saravmajestic/yaerbot/docs/drive-precision.md

# Farm OS — Drive Precision: straight lines and accurate turns

Why the robot doesn't drive straight or turn to an exact angle, what we measured, and
what actually fixes it. Written after a long debugging session on 2026-08-09..11 that
found **three independent faults** stacked on top of each other, plus one property of
skid-steer robots that no amount of tuning removes.

Read this before "fixing the trim" — trim was the wrong answer three times out of four.

> **Status.** The turn problem this document opens with is **solved**: a gyro is fitted and
> turns close the loop on measured angle (0.3° worst over four consecutive 90° turns). What
> is still open-loop is **distance** (timed, no encoders) and **straight-line heading**
> during a hop (`ltrim`). The three faults below are the ones worth knowing about, because
> they cost a week and none of them was the trim.

---

## TL;DR

| Want | Answer |
|---|---|
| Straight hops | trim + all four wheels gripping. Still open-loop: the gyro corrects *turns*, and per-hop heading is measured and logged but not yet steered on. |
| Accurate turns | **Solved.** A gyro is fitted and turns close the loop on measured angle: worst error **0.3°** across four consecutive 90° turns. Open-loop, this was never better than ~±5°. |
| Accurate hop distance | timing works if dead time is calibrated; wheel encoders make it exact. |

**One rule:** before adjusting any control parameter, prove the command reached the motors.
`getDiag` (see below) does that in one line.

---

## The faults we found, in the order they mattered

### 1. Loose IBT-2 signal wiring (worst, and invisible)

Dupont jumpers on the IBT-2 signal header **degrade progressively under vibration**. The
signature is nasty because it isn't a clean failure:

- Early in a session: `fwd 180 4s` → 2.60 m, dead straight
- An hour and a dozen runs later: **the same command drove a half circle**

Because it drifts, every calibration taken during that window is worthless, and any
parameter fitted to it will not converge — we watched a "required trim" climb 1.24 → 1.33
while chasing it. **Solder the signal lines and strain-relieve them to the chassis.**

### 2. One wheel not touching the ground

A **rigid 4-wheel chassis is over-constrained** — like a wobbly table it rests on 3 of its
4 contact points unless the axles are coplanar. On this robot two motor shafts sat ~1 mm
proud of the others; one gripped fine and the other floated, because *which* corner floats
depends on how the frame is twisted, not on height alone. 1 mm matters because a rubber
tire only deflects about that much under a light robot.

Effects, all of which look like other problems:
- the side with the floating wheel loses ~half its traction → large veer
- that side cannot counter-rotate → **turns become forward arcs instead of pivots**
- forward dead time measured **0.524 s** (it was really 0.104 s — the drag inflated it)

Fix: loosen that motor bracket, let the wheel settle on a flat surface, retighten; shim
1 mm if the frame is twisted. Verify all four wheels take load (rock the robot diagonally;
try sliding paper under each wheel).

> **On soil this matters much less** — soft ground conforms to a millimetre and all four
> wheels find grip. Some of what we chased is a hard-floor artifact. Re-test on real
> ground before doing mechanical surgery.

### 3. Normal motor variance — not a fault

Two nominally identical DC gearmotors run **5–15% apart at the same PWM**. It is
manufacturing tolerance (internal resistance, brush friction, gearbox drag) and every
hobby 4WD robot has it. Measured here by counting free-spinning wheel revolutions:
**5 left vs 4.75 right → 5%.** That is normal, and it is what trim is for.

### 4. Rotational coast — a property, not a fault

A skid-steer turn is low-friction, so the chassis keeps spinning after the brake:

| Turn duty | Coast |
|---|---|
| PWM 180 | **~75°** |
| PWM 120 | **~38°** |

At PWM 180 a 90° turn is *mostly* coast, so timing it is hopeless. **Turn at a lower duty.**

---

## The measurement that unlocked it

Two numbers that should have agreed, didn't:

| Condition | Right-side deficit |
|---|---|
| Free-running (revolution count; motor terminals 6.72 V vs 6.64 V = 1.2%) | **5%** |
| Driving under load (inferred from veer geometry) | **25%** |

**Free-running measurements hide load-dependent faults** — no current flows, so nothing
sags and nothing slips. Always take the loaded measurement too (push the robot against a
wall and probe the motor terminals). The 20-point gap was traction, not electrics.

---

## Calibration procedure (works, ~10 minutes)

Use `scripts/field_test.py` on the board. Recalibrate after **any** mechanical or wiring
change — every value below is surface-, battery- and hardware-specific.

```bash
# field_test.py lives in scripts/ — copy it to the app dir first, it is not deployed
scp scripts/field_test.py unoq:/home/arduino/motor-control/python/
FT="ssh unoq docker exec motor-control-main-1 python3 /app/python/field_test.py"

# 0. sanity: does the MCU receive what we send?
$FT diag

# 1. forward: two durations -> cruise speed AND dead time
#    CALIBRATE AT THE DUTY THE ROBOT ACTUALLY RUNS AT — that is PWM 55 now, not 180.
$FT fwd 55 30 0.83      # measure distance
$FT fwd 55 10 0.83      # measure distance
$FT solve 30 <d_long> 10 <d_short>

# 2. turn: two durations at the LOW turn duty -> rate and coast
$FT turn 120 1.5 right  # measure angle
$FT turn 120 0.8 right  # measure angle
$FT tsolve 1.5 <a_long> 0.8 <a_short>

# 3. validate one seeding row
$FT row total=1.2 hop=0.4 turn=90 dir=right \
      speed=<s> startup=<st> ltrim=<lt> tpwm=120 tdps=<r> tstartup=<c> nobatt

# 4. validate the ROW CHANGE (two same-direction 90s + the gap)
$FT uturn leg=1.0 gap=0.4 turn=90 dir=right <same params>
```

**Two models, opposite signs — don't mix them up:**

```
forward:  time = startup_s      + distance/speed      startup_s  > 0   (dead time)
turn:     time = turn_startup_s + angle/tdps          turn_startup_s < 0   (coast)
```

A dead time means *nothing happens at first*; a coast means *it keeps going after you
stop*. If `tsolve` hands you a negative dead time, that's a coast — expected for turns.

### Reference numbers — current (measured 2026-08-18 on soil)

Live values are in `CAL` in `console/python/main.py`. **Plot mode now drives at creep duty
(PWM 55), the same speed as drip seeding**, so one calibration covers both kinds of run
instead of two that can drift apart.

| Parameter | Value | Note |
|---|---|---|
| `pwm` | 55 | forward duty for both plot and drip |
| `speed` | 0.165 m/s | `fwd 55 30` → 5.00 m, `fwd 55 10` → 1.70 m |
| `startup` | **−0.303 s** | negative at this duty — see below |
| `ltrim` | 0.83 | |
| `turn_pwm` | 120 | |
| `tdps` | 45.2 °/s | |
| `tstartup` | −0.80 s | ≈36° of coast |
| `tramp` | 0.0 | ramp available, off |

→ a 40 cm hop is **2.12 s**, not the 0.75 s of the PWM-180 era. A 5 m row takes about 30 s.
Slower is also more accurate, less overshoot per stop — but PWM 55 is near the deadband, so
watch for stiction on rough ground.

**Why `startup` is negative here.** At PWM 180 it was a real dead time (+0.104 s: nothing
happens at first). At PWM 55 the two-point fit comes out negative, which is not a dead time
— it is the straight line through two slow runs having a negative intercept. Treat it as a
fitted constant for this duty, not as physics. The older PWM-180 pair (speed 0.640,
startup +0.187) is kept in the code comments so it is not lost.

---

## Measure the thing you can actually measure

Most of our bad data came from eyeballing angles. Reframe the measurement:

| Don't measure | Measure instead | Why |
|---|---|---|
| "is that 90°?" | **a full/three-quarter circle** | back-to-parallel is easy to judge; 90° is not |
| turn angle in degrees | **lateral offset in cm** over a known distance | tape measure, not judgement — then compute the angle |
| "did it veer?" | offset **per metre** | comparable across runs of different length |
| each 90° of a row change | **are the two legs parallel** | that's the output that matters operationally |

Angle from offset, for a constant-radius arc over path length `s`:

```
(s/θ)(1 − cos θ) = offset          → solve θ
R = s/θ ;  speed difference = track_width / R   (as a fraction of average speed)
```

Worth building: tape a laser pointer to the chassis and mark a wall, or lay a printed
protractor under the pivot point.

---

## Software solutions

### Implemented

- **Dead-time model on forward** (`startup_s + d/speed`). Without it a 40 cm hop is issued
  as a sub-dead-time burst that barely translates — this is why an early boustrophedon
  attempt "rotated randomly within a 30 cm square" instead of driving rows.
- **Coast model on turns** (negative `turn_startup_s`), with the sleep clamped at zero:
  a turn smaller than the coast angle is simply not achievable at that duty.
- **Separate turn duty** (`turn_pwm`) — forward wants 180, turns want 120. One shared duty
  cannot express both.
- **Deceleration ramp** (`turn_ramp_s`, default off) — steps duty down to a floor over the
  last fraction of a turn, then brakes. Coast scales with spin speed at brake time, so
  easing off first shrinks the coast *and* its run-to-run scatter. There is still only one
  stop, and it happens slowly. Calibration is unaffected as long as the ramp is fixed.
- **Battery compensation** — scales duty by `V_cal/V_now` to hold the calibrated speed
  (symmetric; clamped 0.75–1.5×). **Currently inoperative:** the divider was on A4, which
  the gyro took, so `BATT_PRESENT 0` and every run passes `nobatt`. The gain is 1.0.
- **Closed-loop turns** — `pivotDeg` on the MCU drives until the measured rotation reaches
  target, so coast and surface stop mattering: the result is measured, not predicted.
  Worst error 0.3° across four consecutive 90° turns.
- **`getDiag` self-checking** — after every move, compares what we sent against what the
  MCU latched and drove, and prints a `!!` banner on mismatch. Catches a broken command
  path *before* you start blaming control parameters.

### Available, not yet done

- **Fewer turns.** Every turn is an error source. Run rows along the **long** axis of the
  plot. A serpentine alternates turn direction between ends, so systematic overshoot
  partly cancels across a full cycle — but *not* within one row change (see below).
- **Auto-calibrate per surface, at the start of a run.** Half done: the MCU already learns
  pivot coast run-to-run with an exponential average, so it adapts to the ground it is on.
  What is missing is a deliberate known-angle turn at the start of a run to seed it — and
  **the learned coast is lost on reboot**, so the first turn after a power cycle uses the
  built-in guess.
- **Steer on heading during a straight hop.** The gyro closes the loop on turns; a hop is
  still open-loop with `ltrim`. Per-hop yaw is measured and logged, but nothing acts on it.

### The row change was the precision bottleneck ✅ **largely solved**

`A → B` (row), `B → B1` (**90°, row gap, 90°**), `B1 → C` (next row). **Both turns go the
same way**, so a *systematic* per-turn overshoot **doubles**: 10° per turn left the next row
20° skew. That was the open-loop failure. Closing the loop on the gyro takes the per-turn
error to about 0.3°, so the doubling is now under a degree. The geometry lesson still holds
for anything that stays open-loop:

- Tune the row change **as one primitive** (`field_test.py uturn`), not as two 90° turns.
  Its two outputs are separately measurable — heading (are the legs parallel?) and lateral
  (is the spacing the row gap?) — so two measurements pin two parameters.
- The row gap here equals the **seeder arm's outlet spacing**, so lateral error shows up
  directly as wrong seed spacing between rows.

---

## Hardware solutions, ranked by value per rupee

> **What was actually fitted:** a hand-wired **MPU-6050 on A4/A5** via `Wire2`. No wheel
> encoders.
>
> The plan below preferred a **Modulino Movement** on the Qwiic connector — no soldering, no
> GPIO cost. It went the other way for one reason: **the header pins marked SDA/SCL do not
> work for I²C on this core**, and `Wire2` on A4/A5 is the only solderable I²C the board has.
> Qwiic (`Wire1`/i2c4) does work but needs a JST-SH cable. A4/A5 were already spoken for, so
> the gyro cost the battery monitor its input — see [`bom.md`](bom.md).

### 1. IMU — highest value ✅ **done**

**MPU-6050 on A4/A5** (`Wire2`). Not the header `SDA`/`SCL` pins — those have no I²C
peripheral behind them on this core, so a bus scan there finds nothing however correct the
wiring looks.

Uses the **gyro only**: integrate yaw rate and turn until the measured angle reaches target.
Gyro drift is irrelevant over a 1–2 s turn. Coast stops mattering because you measure the
result instead of predicting it. This is what took turns from ±5–10° to 0.3°.

```
target = 90°
while |target − measured| > 2°:
    duty = clamp(Kp × error, 80, 140)     # automatically slows near target
stop, settle, re-read; one micro-correction if still out
```

Surface-independent, battery-independent, self-correcting. It **could** also remove the need
for trim by holding heading during a straight hop — that part is not built; hops still use
`ltrim`. For production use
a **BNO085/BNO055** (~₹1500–2500): on-chip fusion, absolute heading, no hand-rolled drift
maths. Mount on foam, away from the motors.

### 2. Wheel encoders — for distance, not for heading ⬜ **not fitted**

Be clear what they buy: in a skid-steer the wheels **slip by design during a turn**, so
heading derived from wheel difference is unreliable exactly when you need it. Encoders fix
**hop distance** (replacing the timing model); the IMU fixes **heading**. Different jobs.

Cheap option: **LM393 slot sensor + 20-slot disc** (~₹80–150). Tie both channels per side,
one digital pin, poll it (~30–50 pulses/s at our speed — no interrupt needed). A ~65 mm
wheel with 20 slots gives ~1 cm per pulse. Best implemented as a `driveDistance(pulses)`
RPC so the MCU closes the loop itself.

### 3. Mechanical — partly done

- **Wheelbase vs track.** A skid-steer with a *long* wheelbase relative to its track (32 cm
  here) scrubs hard and resists turning. Aim for wheelbase ≤ track.
- **All four wheels loaded** — shim coplanar, or add a rocker/suspension for uneven ground.
- **Weight distribution.** 4-wheel skid-steers turn *worse* at 50/50 front/rear — they buck
  and scrub. Deliberately loading one axle improves turning.
- **Tires** matched, clean, not glazed; narrower scrubs less.
- **Solder power and signal**, strain-relieved. Dupont goes high-resistance under load —
  the same lesson as the battery divider and the motor drive.

### Production stack

```
distance  ← wheel encoders        (closed-loop hops)      ⬜ not fitted — still timed
heading   ← IMU gyro              (closed-loop turns)     ✅ fitted, turns only
          ← ... + straight-line hold                      ⬜ not built — hops use ltrim
position  ← RTK GPS               (absolute reference)    ⬜ deliberately not used
```

---

## Debugging lessons (the expensive ones)

1. **Verify the command path first.** `getDiag` proves what the MCU received and which pins
   it drove. Without it we spent a dozen runs tuning parameters against a loose wire.
2. **Free-running measurements hide load-dependent faults.** Take the loaded one too.
3. **Don't re-fit the model to each new reading.** Hold several hypotheses and pick the test
   that *discriminates* between them. A theory that changes with every data point isn't a
   theory.
4. **A parameter that won't converge is telling you something.** "Required trim" climbing
   1.24 → 1.33 → never straight meant the fault wasn't trim-shaped at all.
5. **Small voltage differences don't cause big speed differences.** 1.2% of volts buys ~1.2%
   of speed. To explain 20% you need ~1.3 V, not 0.08 V.
6. **Beware the compensating parameter.** `ltrim=0.75` masks an asymmetry rather than fixing
   it, so it drifts as the pack sags. Note which parameters are papering over hardware.
7. **Check the newest change first.** Newly-mounted wheels, freshly-soldered joints, a
   just-flashed sketch. And **back up firmware before overwriting it** — we lost the ability
   to A/B a flash because the only copy of the previous sketch was clobbered.

---

## See also

- [`bom.md`](bom.md) — what is actually fitted
- [`troubleshooting.md`](troubleshooting.md) — connector, network and flashing failures
- `apps/farm-robot/docs/farm-os/wheel-encoder-build.md` in the **ai-labs** repo — how to
  build and mount a distance encoder, if one is ever fitted
- `apps/farm-robot/docs/farm-os/uno-q-wiring.md` in the **ai-labs** repo — pinout as it
  stood then. Superseded: the IMU went on **A4/A5** (`Wire2`), not the header SDA/SCL pins,
  which have no I2C peripheral behind them. Current sheets: `docs/schematic/`
- `firmware/farm_os/farm_os.ino` — `getDiag`, optional IBT-2 current sense (`CURRENT_SENSE`)
- `scripts/field_test.py` (yaerbot) — `diag`/`fwd`/`turn`/`solve`/`tsolve`/`row`/`uturn`/`plan`
