saravmajestic/yaerbot/docs/ml-emitter-model.md

# ML Emitter Model — capture → train → deploy

The **single** reference for the Edge Impulse FOMO emitter detector: how frames are
collected, labelled, trained, and how the model actually reaches the robot. Everything
below is verified on hardware unless marked otherwise — most of it was learned the hard
way on 2026-08-15/16.

> **Why this model exists:** classical CV could not tell an emitter from the tube it sits on.
> A learned model can, and it runs on the board. `vision/detect_emitter` stays as the automatic
> fallback, so nothing is blocked if the model underperforms.

> **Current state, 2026-08-19.** Deployed model is **v8** (§4), bound in `app.yaml`, gate
> `_EMIT_CONF = 0.60`. v8 closed the mid-frame blind spot: 7 of 19 frames now detect in the
> middle of frame against 0 before, which is what gives the robot room to stop.
> **The open problem is false positives on plain tube**, which is why a 12-emitter row draws
> about 14 stops. Fixing it needs negatives in the training set, not another threshold change.
>
> Also note the camera changed: frames are now **320×240 from a USB webcam seeing 43cm of
> ground**, not the ESP32-CAM's 22cm. Fire-rate figures measured before the swap are not
> comparable with ones measured after it.

---

## 0. The pipeline at a glance

```
USB camera ──V4L2──> UNO Q Linux ──> _cam_loop ──> detect_emitter_ml()
                                                        │  (falls back to
                                                        │   classical CV)
                                        HTTP :1337 ─────┘
                                        ei-obj-detection-runner container
                                        running your .eim
```

The model does **not** load in-process. The `object_detection` brick posts JPEGs to a
**separate container** over HTTP on port 1337. That container is started by App Lab
because the app declares the brick.

---

## 1. Capture

**Camera tab → "▶ Follow tube & capture"** (`scan` run mode). It creeps along the drip
line via classical CV and saves raw frames; **the seeder is never touched**. Capture
switches on automatically at start and off at Stop.

Or capture without driving: **Camera tab → Dataset capture → Start** (interval slider).

| | |
|---|---|
| Saved to | `~/motor-control/captures/cap_YYYYMMDD_HHMMSS_mmm.jpg` on the robot |
| Format | full-res **raw, unannotated** JPEG (~16–20 KB at 320×240) |
| Persistence | `/app/captures` is bind-mounted to the host — survives container restarts |
| Video | **none.** Stills only; there is no `VideoWriter` anywhere |

Pull them off and clear the board:

```bash
scp "unoq:/home/arduino/motor-control/captures/*.jpg" apps/farm-robot/captures/
ssh unoq 'rm -f /home/arduino/motor-control/captures/cap_*.jpg'
```

> `captures/` is **gitignored** — a real session runs to thousands of frames.
> Always hash both sides before deleting from the board.

### Capture gotchas

- **The UI count badge is an in-memory counter, not a directory scan.** It resets to 0
  on container restart and will not notice a manual `rm`. Trust `ls | wc -l`.
- **Watch the count, not the clock.** If it stops climbing the stream has died and you
  are recording nothing. At a 2 s interval it should rise ~30/minute.
- Neither the link nor the disk is the limit any more (15 GB free ≈ 250k frames). The USB
  camera delivers a steady 30 fps, so the capture interval is the only thing setting the rate.
  *(Historical: over the ESP32-CAM's WiFi MJPEG the link was the limit, and a dropped
  association was permanent until power-cycle unless `esp32_cam.ino` had been flashed.)*
- **Match capture conditions to demo conditions** — same time of day, sun angle, soil
  moisture. A model this narrow will not generalise, which is a fine trade for a single
  take, but only if the take looks like the training data.

---

## 2. Prune and label

Upload the folder to **Edge Impulse Studio** (web — nothing to install; the CLI is
optional). Settings that matter:

- Upload mode **folder**, image label format **Unlabeled**, label **Leave data unlabeled**
- **Automatically split** train/test

Then **Data acquisition → Labelling queue** and draw boxes.

| Rule | Why |
|---|---|
| Class name **`emitter`**, lowercase | must be in `EMITTER_LABELS` in `vision/emitter_ml.py`, else every detection is filtered out |
| **ONE box per emitter**, covering both holes | the pipeline consumes a single `position` per detection and plants a cross around it. FOMO predicts centroids on a grid ⅛ the input size, so two holes millimetres apart land in the same cell and cannot be separated anyway |
| **Label every emitter in every frame** | an unlabelled emitter teaches the model that emitters are background |
| **Keep** clean no-emitter frames, unlabelled | useful negatives |
| **Keep mildly motion-blurred frames** | ⚠️ the robot detects emitters **while moving** — it only stops once one is found. Creep-speed blur is the *operating condition*, so a model trained only on sharp frames fails exactly when it matters. Train on what you will infer on. |
| **Drop** only frames too blurred for *you* to locate the emitter, and frames where the tube has left the frame | genuinely unusable, and the tube-off-frame ones are where the follower was already failing |

Consecutive frames are near-duplicates, so Studio's **object tracking** in the labelling
queue propagates a box forward — 170 manual labels becomes ~20 corrections.

> **What matters is the number of labelled emitter instances, not the file count.**
> Under ~50 and no amount of tuning will substitute for another capture pass.

---

## 3. Train

**Create impulse** → Image block + **Object Detection (Images)** → **FOMO**.

**Set the image size to 160×160, not the 96×96 default.** The emitter is ~5–8 px in a
320-wide frame; at 96×96 it shrinks to ~2 px against a grid whose cells are 8 input px
each, and it trains badly.

### Reading the metrics

Both numbers mislead, in opposite directions:

- **FOMO's F1 reads low.** It scores on centroid matching — a near-miss counts as a
  false positive *and* a false negative. 66.7% F1 corresponded to **99.3% confidence**
  on a real frame when tested directly against the runner.
- **The test accuracy reads high.** The random train/test split leaks: consecutive
  frames 2 s apart are near-duplicates, so test frames are effectively training frames.

**Judge the model on the live annotated view, not on either number.** If you want an
honest figure, upload one drive as Training and a *separate* drive as Test.

Check whether errors are FN or FP — they mean different things: mostly-FN is fixable by
lowering `_EMIT_CONF`; mostly-FP is made *worse* by it.

### The bar to beat — measured baseline, 2026-08-18

Scored with `scripts/score_emitter_model.py` against the 77 USB frames in `captures/usb/`
(62 dataset frames + 15 detector-failure frames), probing at conf ≥ 0.05 to see everything
the model proposes rather than only what clears our gate:

| | first trained model |
|---|---|
| frames scored | 77 |
| frames with **any** box | **56 (73%)** |
| confidence min / median / max | 0.603 / **0.916** / 0.997 |
| frames clearing 0.50 / 0.70 / 0.90 | 56 / 49 / **29** |

> ### ⚠️ CORRECTION 2026-08-18 — the headline claim above was WRONG
>
> An earlier version of this section said `cap_20260818_040718_843.jpg` scored **0.997** on a
> frame holding *"plain drip tube and no emitter"*, and that became the main justification for
> retraining. **That frame does contain emitter holes.** It was judged at full-frame zoom, where
> a 4-6px hole is invisible; zooming later found them, and the model's detection at (238,60)
> sits ~16px from one. The conclusion was never revisited after the zoom.
>
> **What survives:** a **73% fire rate** with a **0.916 median** and no gap in the distribution
> is still a real problem and still justified the retrain.
>
> **⚠️ RE-ESTABLISHED 2026-08-19 — the withdrawal above was too broad.** Only the claim about
> *that one frame* was wrong. "It fires on bare tube" is true, and it is now the accepted root
> cause of the emitter count being wrong: **three boxes at up to 0.97 on a frame holding plain
> tube and no emitter**, plus **145 boxes across 60 frames of leaf litter**. A 12-emitter row
> draws about 14 stops because of it. The operator raised this days before it was accepted, and
> the retraction above cost roughly ten iterations of counting logic that could not have worked.
> **The counting logic is frozen until the model is retrained with plain-tube and leaf-litter
> negatives.**
>
> **The lesson worth keeping:** these emitters are 4-6px features. *Never judge a detection from
> a full-frame view* — crop and upscale around the predicted centroid before deciding it is
> wrong. Two conclusions in one day were withdrawn for exactly this.

A high fire-rate with a high median and no gap in the distribution is the signature of a model
answering *"tube"* rather than *"emitter"*. Do not tune the threshold against a model in that
state; the fix is negatives in the training set.

A retrain has worked when the plain-tube frames go QUIET while labelled emitters still fire. It
has **not** worked if everything merely scores lower — that just slides the overlap.

> The emitters on this tube show up **two ways**, and both matter for labelling:
> * **small dark punched holes in the tube wall, ~4-6 px across** at 320x240; and
> * **white/pale salt crust around the outlet** — the irrigation water is saline, so minerals
>   deposit exactly where water evaporates. On a used stretch of tube the crust is the LARGER
>   and more reliable cue, and the retrained model keys on it heavily.
>
> Both are only clearly visible zoomed; at 100% you will miss them, and a missed emitter in a
> saved frame actively teaches the model that emitters are background. **Zoom in while labelling.**

---

## 4. Retrain history

### v6 — 2026-08-18 (`squash`)

Scored on `captures/dense/` — 298 frames sampled from a 2086-frame pass captured AFTER the
training set was labelled, so a genuine held-out set.

| | first model | **retrained** |
|---|---|---|
| frames firing (conf ≥ 0.05) | 73% | **38%** |
| median confidence | 0.916 | 0.875 |
| resize mode | fit-shortest | **squash** |

**38% was consistent with the geometry rather than evidence of over-firing** — *for the camera
of the time*. Emitters ~40cm apart against a **22cm** visible strip means ~55% of frames should
contain one, so the model fired slightly *under* the expected rate.
**This arithmetic is now stale:** the QHM-999RL sees **43cm** of ground, wider than the 40cm
spacing, so nearly every frame should hold an emitter. Any fire-rate scored before the camera
swap cannot be compared with one scored after it. High-confidence detections land on salt crust, i.e. on a real
feature.

### `_EMIT_CONF` — settled at 0.60

> **Answered.** This section asked for a dry-run validation; it happened. `_EMIT_CONF` is
> **0.60**, not the 0.80 below. v8's confidences on real emitters run 0.66–1.00 with a median
> near 0.97, so a higher gate is tempting — but the two lowest (0.66, 0.79) are exactly the
> frames v6 missed entirely, so **0.60 is what buys the recall**, and with zero measured false
> positives on the fixture sets there was nothing to trade it against. Do not raise it on a
> distribution. The reasoning is pinned in `tests/test_emitter_e2e.py`.

The historical arithmetic that prompted the question, kept because it shows the method: the
plant trigger needs a detection in the lower 45% of frame (`_EMIT_MIN_Y_FRAC`) **and**
confidence ≥ `_EMIT_CONF`. On the v6 held-out set:

```
fired in the reach band : 76 / 298 (26%)   median confidence 0.843
  gate 0.90 ->  19 frames would trigger    (~3 qualifying frames per emitter)
  gate 0.80 ->  40 frames                  (~8 per emitter)
  gate 0.70 ->  47 frames
```

0.90 sits **above** the reach-band median. Three qualifying frames per emitter is enough for the
edge-triggered plant to fire once, but there is almost no margin.

And note *why* 0.90 was chosen: to reject three "false positives on plain tube" scoring
0.57 / 0.77 / 0.87 — and at least one of those frames contained real emitter holes (see the
correction above). **The gate was set high partly on misread evidence.**

At the time `_EMIT_CONF` was set to **0.80**. To validate it, the method was: run a drip dry run
**with dataset capture ON** and check both directions:

* **Too high** → the robot walks past emitters. Only visible if you have continuous frames,
  because a skipped emitter leaves no `emitN_latM` frame behind. This is why capture matters:
  drip mode does **not** enable it automatically (only scan mode does).
* **Too low** → it stops at bare tube. Visible directly in the saved `emitN_latM` frames.

Each stop logs its confidence, so the log plus the captures answer it in one run:
`emitter 3 — STOPPED at 1.24m (conf 0.86, ml 0.86, y=181/240) [frame emit3_lat1_HHMMSS.jpg]`

### v8 — 2026-08-19 · **this is the deployed model**

`ei-deployment-version 8`. Scored against the 19 saved `emitN_latM` frames and the fixture
sets in `tests/frames/`:

| | v6 | **v8** |
|---|---|---|
| gained / lost detections | — | **+3 / −0** |
| detections in the **middle** of frame | **0** | **7 of 19** |
| frames detected, of 19 | 15 | **18** |
| boxes on 17 no-emitter frames | — | **0** |

**The number that mattered was position, not confidence.** Under v6 every confident detection
sat at `y ≥ 190` — the point where the emitter is nearest and largest — which left the robot
almost no room to stop. v8 spreads them: far 1, mid 7, near 10. Seven mid-frame detections
against none is the blind spot closing, and it is why retraining beat another threshold tweak.

Pinned as a regression baseline in `tests/test_emitter_e2e.py`, with the per-frame before/after
table. Re-baseline deliberately when the model changes on purpose — never to make a red test
green.

**Still open in v8:** it fires on plain tube (see the correction in §3). That is the next
retrain's job, and it needs negatives.

---

## 5. Deploy

**Deployment target: `Arduino UNO Q`** — *"An EIM binary for the Arduino UNO Q CPU"*.

- ❌ **not** `Arduino VENTUNO Q` — a different board, with Qualcomm NN accelerators
- ❌ **not** `C++ library (Linux)` — source you would have to compile yourself
- ✅ Choose **float32 (unoptimized)**, not the quantized build. Quantizing saves RAM
  (393 KB vs 1.5 MB), which matters on a microcontroller and **not at all** on a 4 GB
  Linux board. Don't trade accuracy for a resource you have in abundance.

Also set the **header target** away from the `Cortex-M4F 80MHz` default — it drives the
RAM/latency estimates, and MCU figures are meaningless for a model running on the
Qualcomm Linux side. Changing it re-computes estimates only; **it does not invalidate
your data, labels or trained weights.**

### Getting the model onto the robot

**The supported path is App Lab, and App Lab requires the USB-C cable.**

```
Connect UNO Q by USB-C (direct, not through a hub)
  → open the "Farm Robot Control" app          ← per-app, not a global setting
  → Bricks → Object Detection → AI Models
  → link the Edge Impulse account, select the project
  → install to board
```

**Network connection is not a substitute.** Verified on the board:

| | |
|---|---|
| App Lab daemon `:8800` | bound to **127.0.0.1 only** |
| Only network-facing port | SSH (22) |
| mDNS advertises `_arduino._tcp` | on port 80, where **nothing listens** |
| `arduino-router-serial.service` | proxies to `ttyGS0` — a **USB** gadget serial |

Over the network App Lab shows the brick catalogue and the cloud Edge Impulse link (so
your project appears), but lists **no apps** and the model Download fails with no trace
in the board's logs — because there is no board context to install into. Nothing is
broken; it is USB-transport by design.

**Do not use "import from computer"** — it creates a *new* app and can clobber the
running `motor-control`.

> The `/v1/models` registry on the board is **read-only and cloud-backed** (`Allow: GET,
> HEAD`; the model ids are not in the binary or any local file). There is no local file
> to edit to register a custom model, and `app-compose-overrides.yaml` is **regenerated
> on every app start**, so hand-editing it is silently reverted.

### Why `object_detection` and NOT `video_object_detection`

App Lab also offers `arduino:video_object_detection`. **Do not use it here.** Its
`brick_config.yaml` declares `required_devices: [camera]` and its runner is started with
`--mode streaming --camera /dev/video1`:

- it would **own the stream** and emit its own annotated video, bypassing `_cam_loop`, which
  is deliberately the *sole consumer*: one frame feeds tube-steering, the emitter detector,
  dataset capture and the browser overlay. That is the reason that still holds.
- `object_detection` takes **image bytes**, which is exactly what `_cam_loop` already has
- it hardcodes a camera index, and **`/dev/video` indices are not stable across boots** on
  this board, so a pinned `--camera /dev/video1` is a coin flip

> **One original reason has expired.** This used to read "there is no local `/dev/video*` to
> give it" — true of the ESP32-CAM over WiFi, false now that the camera is USB. The decision
> stands on sole-consumer ownership and the unstable index, not on the device node.

> **"Video" does not mean de-blurred.** That brick runs the same model on the same
> individual frames — the word describes input plumbing and streaming output, not
> temporal processing. Motion blur is optical (exposure × speed); the fixes are more
> light, slower motion, or a shorter shutter — never a different brick.

### Prerequisite: the brick must be declared

`console/app.yaml` must list the brick, or the runner container never starts:

```yaml
bricks:
- arduino:web_ui: {}
- arduino:object_detection:
    model: ei-model-1088852-1     # id from: curl 127.0.0.1:8800/v1/models
```

**The entries are mappings, and `model:` is the whole point.** Without it App Lab starts the
runner with the out-of-the-box `yolo-x` and serves 80 COCO classes. Because the binding lives
in `app.yaml` rather than being clicked in the UI, it survives `app start` and a reboot.

**Failure is silent** — the app runs, the runner reports healthy, and nothing looks wrong.
Always verify the labels (§6).

---

## 6. Enable and verify

**The ML path is ON by default.** `emitter_ml.py` still gates the brick import behind an env
var — constructing the brick with no model blocks ~60 s trying to reach the runner — but the
default is now enabled:

```bash
FARMOS_EMITTER_ML=0     # force the classical detector instead
```

Set to `0`/`false`/`no`/`off` and `ml_available()` stays `False`, and the console silently uses
classical CV.

Restart the app, then confirm from the camera-loop log line:

```
camera loop (sole consumer): ...  [emitter: ML/Edge-Impulse]   <- ML live
camera loop (sole consumer): ...  [emitter: classical CV]      <- still fallback
```

Confirm the runner has **your** model, not the OOTB `yolo-x-nano`:

```bash
ssh unoq 'curl -s http://127.0.0.1:1337/api/info' | head -20
# want: project.name = your project, labels = ['emitter'], input 160x160,
#       model_type = constrained_object_detection      (NOT 80 COCO classes)
```

---

## 7. Gotchas that cost real time

### The detect() response shape — three traps

`ObjectDetection.detect()` does **not** return the raw Edge Impulse JSON. Verified on
the board:

```python
# what the brick returns
{"detection": [{"class_name": "emitter",
                "confidence": "99.33",                 # STRING, 0..100
                "bounding_box_xyxy": [x1, y1, x2, y2]}]}

# what the raw runner returns on :1337/api/image
{"result": {"bounding_boxes": [{"label": "emitter", "value": 0.993,
                                "x": 148, "y": 108, "width": 12, "height": 36}]}}
```

1. the key is **`detection`** — singular, not `detections`
2. the label key is **`class_name`**, not `label`
3. confidence is a **percentage string**, not a 0–1 float

`_extract_boxes()` handles both shapes now. It originally guessed and matched neither,
which would have produced a model that loads, logs `[emitter: ML/Edge-Impulse]`, and
detects nothing on every frame. Had only the confidence been wrong, `"99.33"` would have
been read as 99.3 instead of 0.993 and sailed past every threshold.

### The confidence threshold trap

Two thresholds stack, and the arithmetic bites on dry soil:

```
fused = 0.6 * ml_value + (0.4 if wet else 0.0)      # detect_emitter_ml
plant if fused >= _EMIT_CONF (0.60)                 # console
```

A **visual-only** detection maxes at **0.6**, so a 0.9-confidence emitter on dry soil scored
0.54 and never triggered. If the annotated view shows clean detections but nothing plants, this
is the arithmetic to check — not the model.

> **The wet bonus is now deliberately bypassed.** The moisture pins are floating, and a floating
> pin reads *below* the 9000 "wet" threshold, so every frame was collecting the +0.4 for free —
> which is worse than useless, it is a confidence bonus keyed to nothing. `main.py` now passes
> moisture as `None` so `wet` stays `False`. Confidence is the model's own number.

### Fallback workaround (no USB)

Your `.eim` runs in the same container image App Lab uses, so the brick can be pointed
at it manually:

```bash
docker run -d --name eim-test -p 127.0.0.1:1338:1338 \
  -v /home/arduino/.arduino-bricks/ei-models:/models-custom \
  ghcr.io/arduino/app-bricks/ei-models-runner:0.5.0 \
  --model-file /models-custom/emitter-fomo.eim --run-http-server 1338
curl -s -F "file=@frame.jpg;type=image/jpeg" http://127.0.0.1:1338/api/image
```

This is how the model was validated without App Lab. Replacing App Lab's runner the same
way works, but the compose overrides are regenerated on every app start, so it must be
re-applied after each restart. Treat it as a demo-day fallback, not the normal path.

---

## References

- Custom AI models in App Lab — https://docs.arduino.cc/software/app-lab/integrations/ai-models/
- App Lab setup (macOS) — https://docs.arduino.cc/software/app-lab/setup/macos/
- Deploying a `.eim` on the UNO Q — https://forum.arduino.cc/t/how-to-deploy-eim-model-on-arduino-uno-q/1452107
- Code: `vision/emitter_ml.py`, `console/python/main.py` (`_cam_loop`), `console/app.yaml`
