saravmajestic/yaerbot/docs/architecture@2x.png

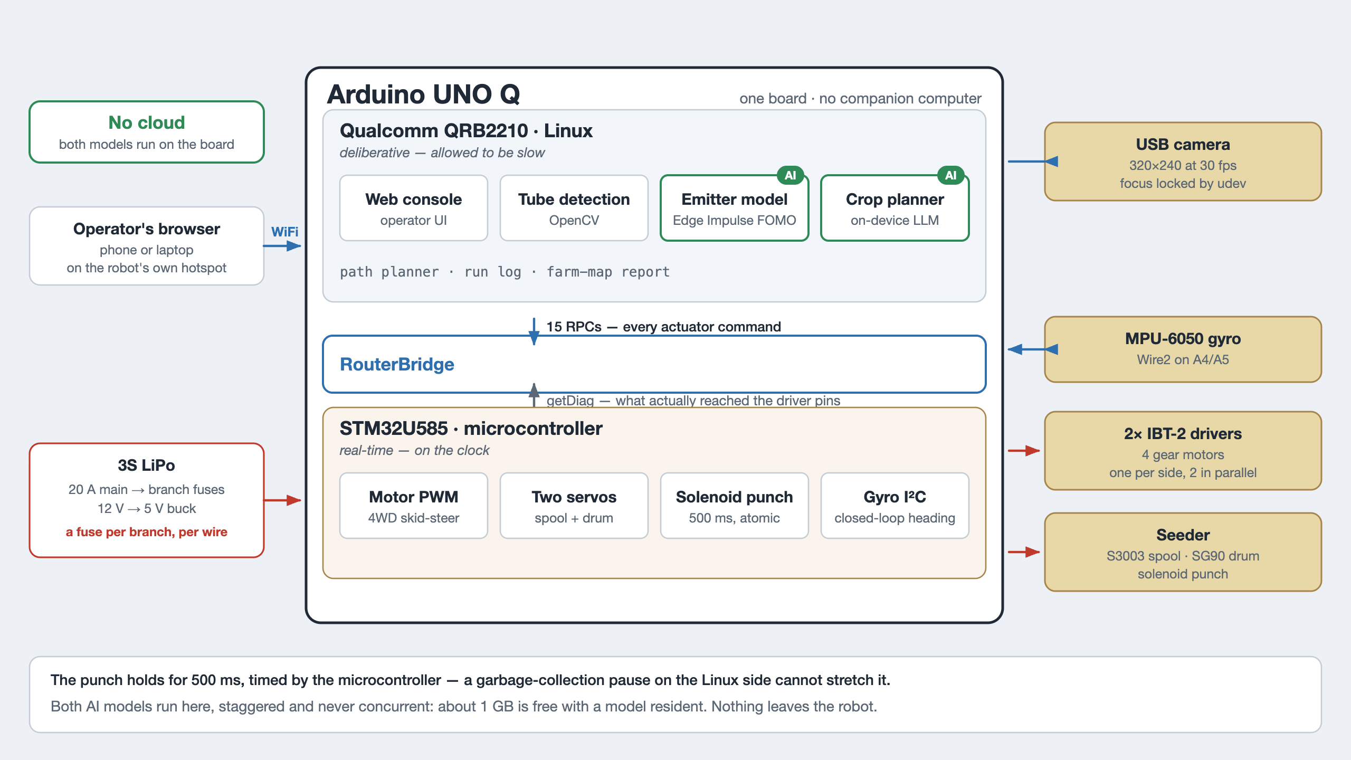
docs/architecture@2x.png
