saravmajestic/yaerbot/tests/frames/align/lat2_align0_023313_081.jpg

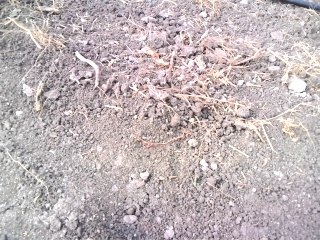
tests/frames/align/lat2_align0_023313_081.jpg
