saravmajestic/yaerbot/tests/frames/align/lat2_align1_023313_785.jpg

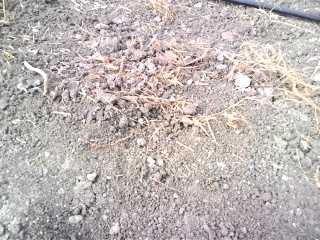
tests/frames/align/lat2_align1_023313_785.jpg
