saravmajestic/yaerbot/tests/frames/align/lat2_align2_023314_684.jpg

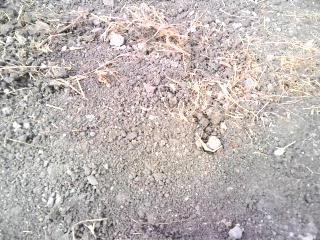
tests/frames/align/lat2_align2_023314_684.jpg
