saravmajestic/yaerbot/tests/frames/align/lat2_align3_023315_853.jpg

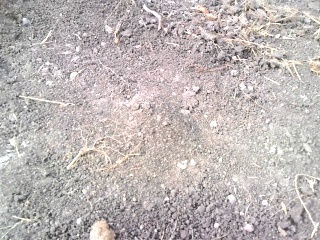
tests/frames/align/lat2_align3_023315_853.jpg
