saravmajestic/yaerbot/tests/frames/align/lat2_align4_023317_014.jpg

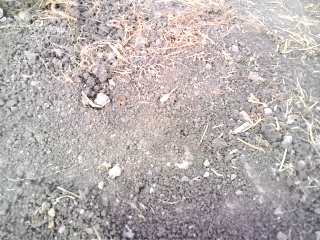
tests/frames/align/lat2_align4_023317_014.jpg
