saravmajestic/yaerbot/tests/frames/align/lat2_align4_024621_563.jpg

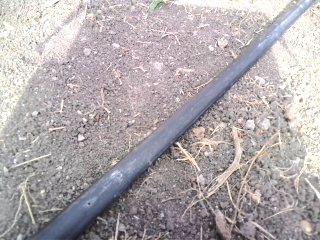
tests/frames/align/lat2_align4_024621_563.jpg
