saravmajestic/yaerbot/tests/frames/align/lat2_align5_023318_192.jpg

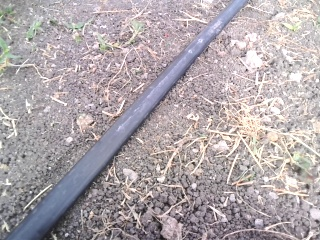
tests/frames/align/lat2_align5_023318_192.jpg
