saravmajestic/yaerbot/tests/frames/align/lat2_found_023307_576.jpg

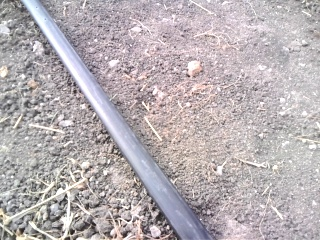
tests/frames/align/lat2_found_023307_576.jpg
