saravmajestic/yaerbot/tests/frames/emitter/emit1_lat1_022705_255.jpg

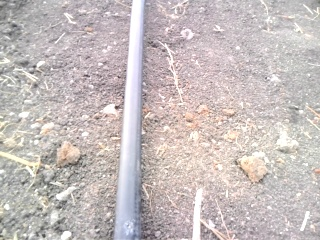
tests/frames/emitter/emit1_lat1_022705_255.jpg
