saravmajestic/yaerbot/tests/frames/emitter/emit1_lat1_023247_035.jpg

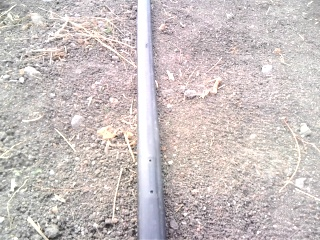
tests/frames/emitter/emit1_lat1_023247_035.jpg
