saravmajestic/yaerbot/tests/frames/emitter/emit1_lat1_024544_797.jpg

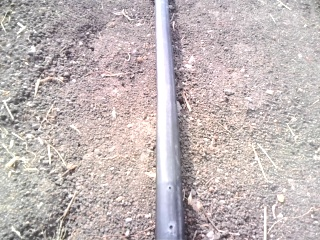
tests/frames/emitter/emit1_lat1_024544_797.jpg
