saravmajestic/yaerbot/tests/frames/emitter/emit1_lat1_024712_361.jpg

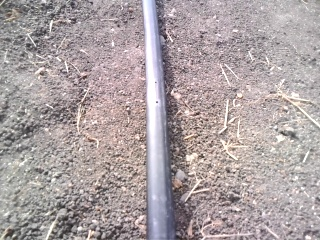
tests/frames/emitter/emit1_lat1_024712_361.jpg
