saravmajestic/yaerbot/tests/frames/emitter/emit1_lat1_025327_534.jpg

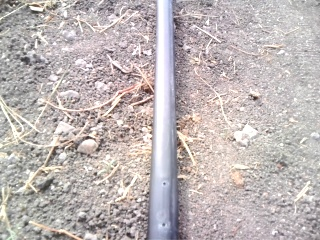
tests/frames/emitter/emit1_lat1_025327_534.jpg
