saravmajestic/yaerbot/tests/frames/emitter/emit1_lat1_025643_705.jpg

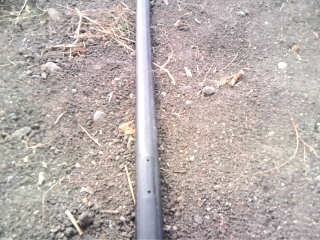
tests/frames/emitter/emit1_lat1_025643_705.jpg
