saravmajestic/yaerbot/tests/frames/emitter/emit1_lat1_025817_493.jpg

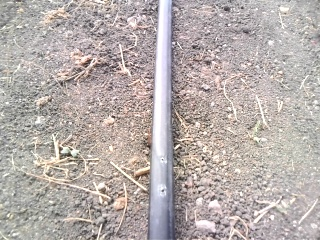
tests/frames/emitter/emit1_lat1_025817_493.jpg
