saravmajestic/yaerbot/tests/frames/emitter/emit1_lat1_030255_230.jpg

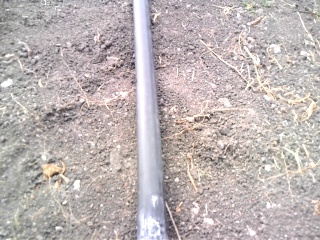
tests/frames/emitter/emit1_lat1_030255_230.jpg
