saravmajestic/yaerbot/tests/frames/emitter/emit1_lat1_111611.jpg

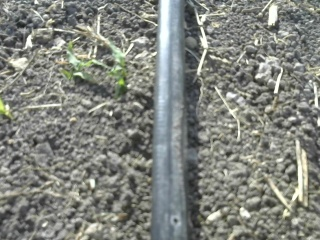
tests/frames/emitter/emit1_lat1_111611.jpg
