saravmajestic/yaerbot/tests/frames/emitter/emit2_lat1_024552_728.jpg

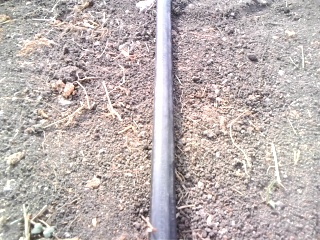
tests/frames/emitter/emit2_lat1_024552_728.jpg
