saravmajestic/yaerbot/tests/frames/emitter/emit2_lat1_024718_164.jpg

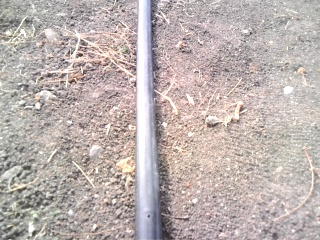
tests/frames/emitter/emit2_lat1_024718_164.jpg
