saravmajestic/yaerbot/tests/frames/emitter/emit2_lat1_025342_761.jpg

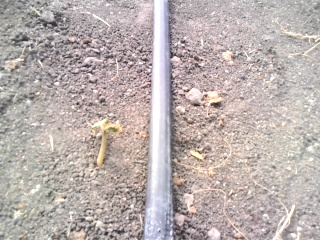
tests/frames/emitter/emit2_lat1_025342_761.jpg
