saravmajestic/yaerbot/tests/frames/emitter/emit2_lat1_025653_793.jpg

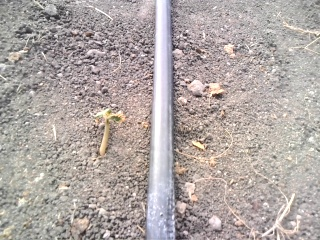
tests/frames/emitter/emit2_lat1_025653_793.jpg
