saravmajestic/yaerbot/tests/frames/emitter/emit2_lat1_025825_168.jpg

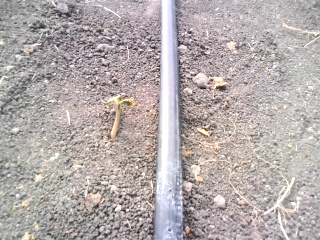
tests/frames/emitter/emit2_lat1_025825_168.jpg
