saravmajestic/yaerbot/tests/frames/emitter/emit2_lat1_030306_133.jpg

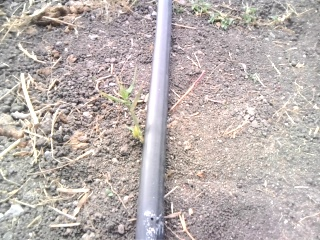
tests/frames/emitter/emit2_lat1_030306_133.jpg
