saravmajestic/yaerbot/tests/frames/emitter/emit2_lat2_023344_413.jpg

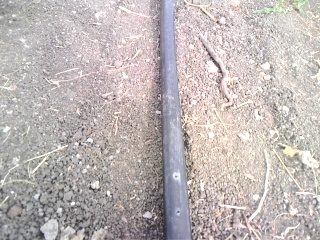
tests/frames/emitter/emit2_lat2_023344_413.jpg
