saravmajestic/yaerbot/tests/frames/emitter/emit3_lat1_024600_270.jpg

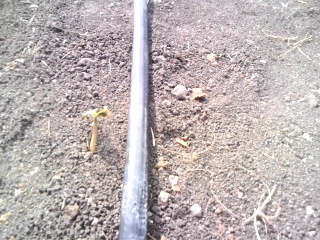
tests/frames/emitter/emit3_lat1_024600_270.jpg
