saravmajestic/yaerbot/tests/frames/emitter/emit3_lat1_024725_616.jpg

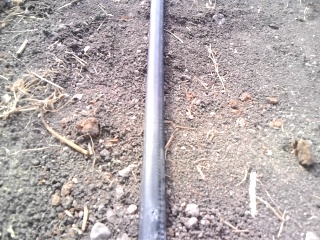
tests/frames/emitter/emit3_lat1_024725_616.jpg
