saravmajestic/yaerbot/tests/frames/emitter/emit3_lat1_025834_914.jpg

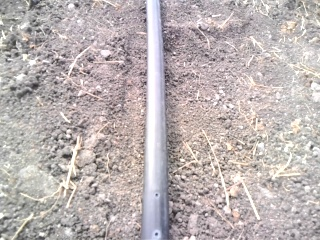
tests/frames/emitter/emit3_lat1_025834_914.jpg
