saravmajestic/yaerbot/tests/frames/golden/cap_20260818_104428_437.jpg

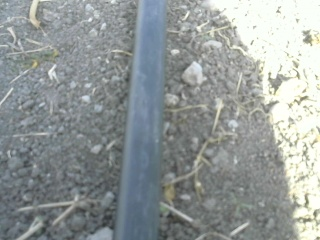
tests/frames/golden/cap_20260818_104428_437.jpg
