saravmajestic/yaerbot/tests/frames/golden/cap_20260818_105926_367.jpg

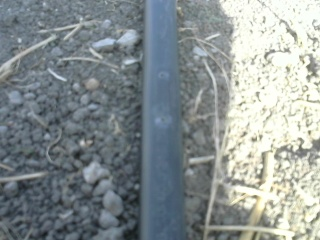
tests/frames/golden/cap_20260818_105926_367.jpg
