saravmajestic/yaerbot/tests/frames/golden/cap_20260818_110502_124.jpg

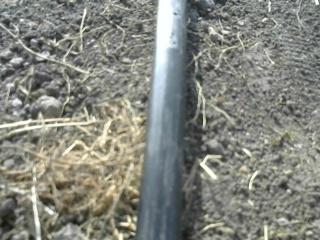
tests/frames/golden/cap_20260818_110502_124.jpg
