saravmajestic/yaerbot/tests/frames/golden/cap_20260819_094944_877.jpg

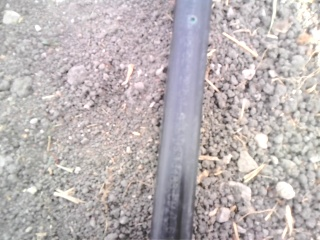
tests/frames/golden/cap_20260819_094944_877.jpg
