saravmajestic/yaerbot/tests/frames/golden/live_1245.png

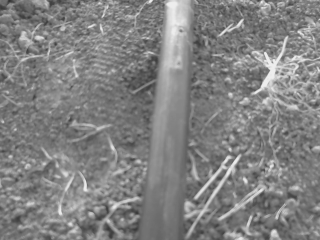
tests/frames/golden/live_1245.png
