saravmajestic/yaerbot/tests/frames/golden/lost_121524.jpg

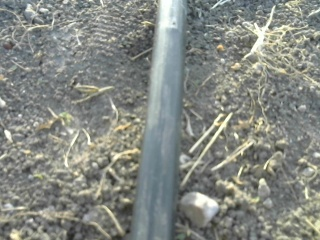
tests/frames/golden/lost_121524.jpg
