saravmajestic/yaerbot/tests/frames/negative/cap_20260817_015250_845.jpg

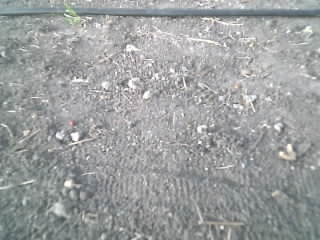
tests/frames/negative/cap_20260817_015250_845.jpg
