saravmajestic/yaerbot/tests/frames/negative/cap_20260817_015329_456.jpg

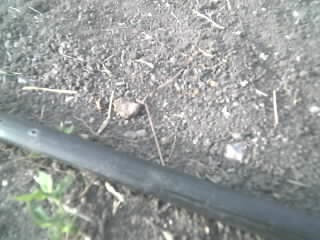
tests/frames/negative/cap_20260817_015329_456.jpg
