saravmajestic/yaerbot/tests/frames/negative/cap_20260817_015403_580.jpg

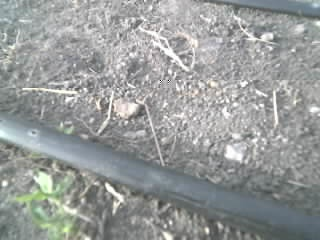
tests/frames/negative/cap_20260817_015403_580.jpg
