saravmajestic/yaerbot/tests/frames/negative/cap_20260817_015415_692.jpg

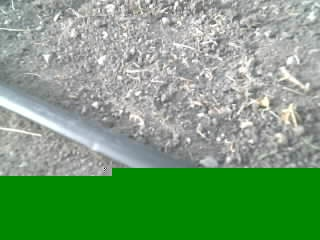
tests/frames/negative/cap_20260817_015415_692.jpg
