saravmajestic/yaerbot/tests/frames/negative/cap_20260817_015431_098.jpg

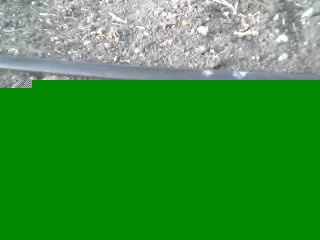
tests/frames/negative/cap_20260817_015431_098.jpg
