saravmajestic/yaerbot/tests/frames/plaintube/plaintube_falsepositive_annotated.png

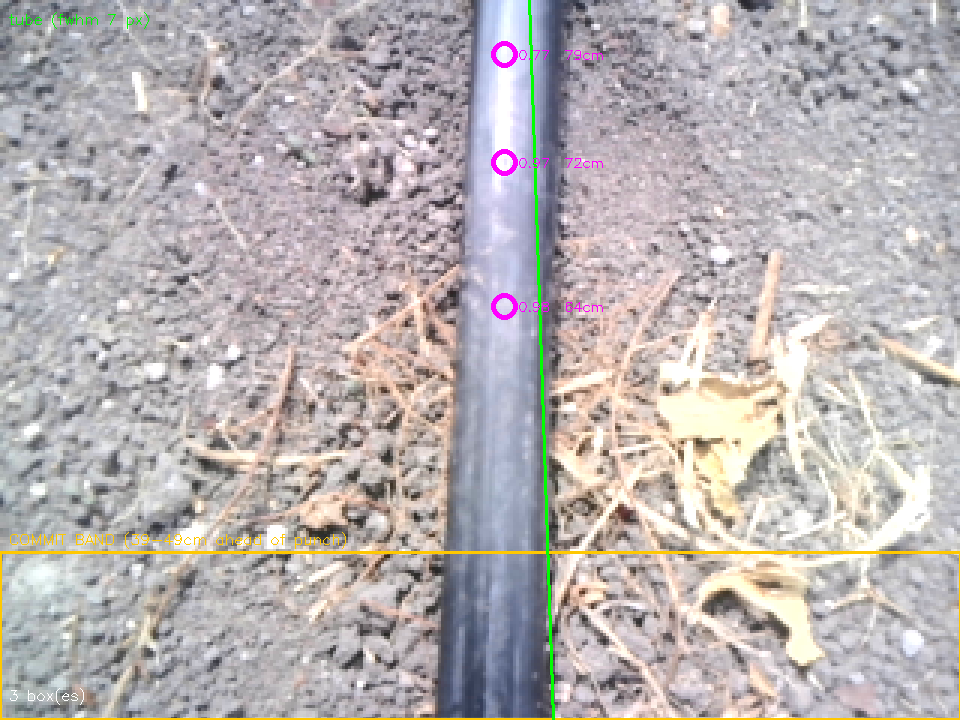
tests/frames/plaintube/plaintube_falsepositive_annotated.png
