saravmajestic/yaerbot/tests/frames/shadow/cap_20260818_022932_586.jpg

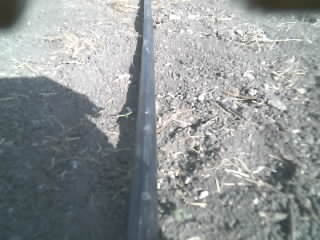
tests/frames/shadow/cap_20260818_022932_586.jpg
