saravmajestic/yaerbot/tests/frames/shadow/cap_20260818_022947_170.jpg

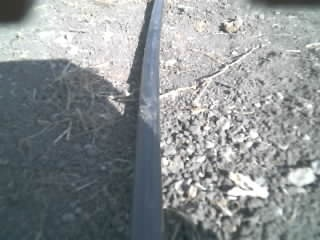
tests/frames/shadow/cap_20260818_022947_170.jpg
