saravmajestic/yaerbot/tests/frames/shadow/cap_20260818_023035_869.jpg

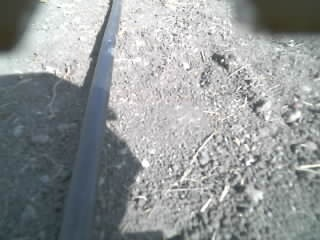
tests/frames/shadow/cap_20260818_023035_869.jpg
