saravmajestic/yaerbot/tests/frames/shadow/cap_20260818_083845_886.jpg

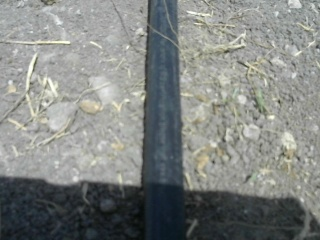
tests/frames/shadow/cap_20260818_083845_886.jpg
