saravmajestic/yaerbot/tests/frames/shadow/cap_20260818_083851_243.jpg

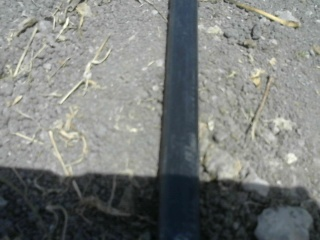
tests/frames/shadow/cap_20260818_083851_243.jpg
