saravmajestic/yaerbot/tests/frames/shadow/lost_014024.jpg

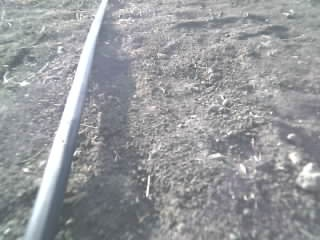
tests/frames/shadow/lost_014024.jpg
