saravmajestic/yaerbot/console/python/main.py

import base64
import json
import math
import os
import socket
import sqlite3
import struct
import subprocess
import threading
import time
import traceback
import urllib.request
from datetime import datetime, timezone

from arduino.app_utils import Bridge, App
from arduino.app_bricks.web_ui import WebUI

# Vision is OPTIONAL — guarded so the operator app runs even if OpenCV / the
# vision package aren't on the board yet. The raw camera feed (an <img> straight
# to the ESP32-CAM) works regardless; only the detection overlay + drip-follow
# need this. To enable on-device: `pip install opencv-python-headless` in the
# container and bundle the repo's vision/ folder next to this app.
_VISION_OK = False
try:
    import sys as _sys
    _here = os.path.dirname(os.path.abspath(__file__))
    # `_here` (contains the vision/ package) + repo root (local dev). NOTE: do NOT
    # add _here/vision to the path — that shadows the `vision` package with its own
    # vision.py module and breaks `from vision.vision import ...`.
    for _p in (_here,
               os.path.abspath(os.path.join(_here, "..", "..", ".."))):  # repo root (local dev)
        if _p not in _sys.path:
            _sys.path.insert(0, _p)
    import cv2  # noqa: F401
    from vision.vision import detect_tube, detect_emitter, detect_crossing, draw_overlay
    from vision.camera import FrameBus
    from vision.emitter_worker import EmitterWorker
    from vision.odometry import FlowOdometer
    # Optional on-device ML emitter model (Edge Impulse via the object_detection
    # brick). Self-guards; falls back to classical detect_emitter if no model.
    from vision.emitter_ml import detect_emitter_ml, ml_available
    _VISION_OK = True
except Exception as _e:                      # noqa: BLE001
    print("vision unavailable (raw feed only): %s" % _e, flush=True)

# Act 2/4 planner + executor + report. Guarded the same way as vision so a missing
# farmos/ can't stop the console from starting.
_PLOT_OK = False
try:
    from farmos import SeedPlan, plan_boustrophedon, execute
    from farmos.executor import RunLog
    from farmos.path import plan_summary
    from farmos.report import render_svg
    from farmos.robot_io import BridgeRobot
    _PLOT_OK = True
except Exception as _e:                      # noqa: BLE001
    print("farmos planner unavailable (Seed tab plot mode off): %s" % _e, flush=True)

ui = WebUI()


# THE OPERATOR LOG MUST SURVIVE A RESTART. `docker logs` is the only record of what a run did,
# and it is volatile: on 2026-08-18 an app restart three minutes after a traverse run destroyed
# the only evidence of why the robot stopped, and the run could not be diagnosed at all. Frames
# survive because _CAP_DIR is bind-mounted to the host; the log did not.
#
# So tee every log line to a file in the app directory, which is the same bind-mounted volume the
# captures and battery CSV already use. Rotates like the battery CSV — one 4MB file plus one .1
# backup, which at a few hundred bytes a line is many hours of runs.
#
# Deliberately best-effort: a full or read-only disk must never stop the robot logging to stdout,
# so every failure here is swallowed after one complaint.
_LOG_FILE = os.path.abspath(os.path.join(os.path.dirname(__file__), "..", "console.log"))
_LOG_MAX = 4_000_000
_log_state = {"warned": False}


def log(msg):
    line = "[%s] %s" % (time.strftime("%H:%M:%S"), msg)
    print(line, flush=True)
    try:
        with open(_LOG_FILE, "a") as f:
            f.write("%s %s\n" % (datetime.now().strftime("%Y-%m-%d"), line))
        if os.path.getsize(_LOG_FILE) > _LOG_MAX:
            os.replace(_LOG_FILE, _LOG_FILE + ".1")
    except Exception as e:                                # noqa: BLE001
        if not _log_state["warned"]:
            _log_state["warned"] = True
            print("persistent log disabled (%s) — stdout only" % e, flush=True)


def logged(name, handler):
    """Wrap a UI message handler so every incoming request + payload is logged."""
    def wrapper(client, data):
        log("rx %-13s %s" % (name, data))
        return handler(client, data)
    return wrapper

# ── Host control (power + network) ─────────────────────────────────────────
# This app runs in an unprivileged container, so it can't power off the host
# or change WiFi directly. It asks the root-side helper (server/power_helper.py)
# over the container's default gateway. Token must match TOKEN in the helper.
HELPER_TOKEN = "farmos-power"
HELPER_PORT  = 7999

def _host_gateway():
    """The container's default gateway IS the UNO Q host.

    Read /proc/net/route rather than shelling out: this image has no `ip`
    binary, so the old `ip route` call always failed and silently fell through
    to a hardcoded address that only happened to be right.
    """
    try:
        with open("/proc/net/route") as f:
            for line in f.read().splitlines()[1:]:
                fields = line.split()
                if fields[1] == "00000000":          # destination 0.0.0.0 = default
                    return socket.inet_ntoa(struct.pack("<L", int(fields[2], 16)))
    except Exception:                                 # noqa: BLE001
        pass
    return "172.19.0.1"

def _helper_request(action):
    gw = _host_gateway()
    url = "http://%s:%d/%s" % (gw, HELPER_PORT, action)
    print("helper: %s -> POST %s" % (action, url), flush=True)
    body = json.dumps({"token": HELPER_TOKEN}).encode()
    req = urllib.request.Request(
        url, data=body, headers={"Content-Type": "application/json"}, method="POST"
    )
    try:
        resp = urllib.request.urlopen(req, timeout=3)
        print("helper: %s -> replied %s" % (action, resp.status), flush=True)
    except Exception as e:
        print("helper: %s request FAILED: %s" % (action, e), flush=True)

_speed = 180  # default ~70% (0-255)

# Trim: reduce the faster side until robot goes straight.
# Robot drifts RIGHT → right motors are faster → reduce RIGHT_TRIM.
# Adjust in 0.05 steps and re-deploy until straight.
LEFT_TRIM  = 0.83      # 2026-08-16: was 0.77; matched to the field-test `ltrim=0.83`
RIGHT_TRIM = 1.00      # that the row/cycle runs are calibrated with. The two had
                       # drifted apart, so the Drive tab steered differently from
                       # field_test.py on the same ground.

def trimmed(left, right):
    return int(left * LEFT_TRIM), int(right * RIGHT_TRIM)


# Calibration measured 2026-08-11 (hard floor, 3S ~12V). These are surface- and
# hardware-specific — recalibrate after ANY mechanical/wiring change with
# scripts/field_test.py (solve/tsolve). See docs/farm-os/drive-precision.md.
# batt_comp stays off: the A4 divider still reads low and wanders.
CAL = {
    # PLOT MODE NOW DRIVES AT CREEP DUTY, matching drip seeding. Changed 2026-08-18 on request:
    # plain-land and drip runs plant on the same ground with the same seeder, and running them at
    # different speeds meant two separate calibrations to keep honest — this project has twice
    # been burnt by a calibration outliving the conditions it was taken under.
    #
    # Both pairs are MEASURED with field_test.py, two runs each so startup dead-time is separated
    # from steady speed rather than smeared into it:
    #     PWM  55:  fwd 55 30 -> 5.00m,  fwd 55 10 -> 1.70m  => speed 0.165  startup -0.303
    #     PWM 180:  fwd 180 8 -> 5.00m,  fwd 180 3 -> 1.80m  => speed 0.640  startup +0.187
    # The old stored pair was 0.628/0.099, i.e. the speed was only 1.9% out — kept above so the
    # 180 calibration is not lost if plot mode is ever moved back to it.
    #
    # THE TRADE: a 40cm hop takes 2.12s instead of 0.81s, so a 5m row is 30s rather than 8s and
    # the 24-spot plot takes roughly 2 minutes of driving instead of 30 seconds. Slower is also
    # MORE accurate — less overshoot per stop — but PWM 55 is near the deadband, so watch for
    # stiction on rough ground. If it stalls or crawls unevenly, that is the reason.
    "pwm": 55, "speed": 0.165, "startup": -0.303,
    "ltrim": 0.83, "rtrim": 1.00,
    "turn_pwm": 120, "tdps": 45.2, "tstartup": -0.80, "tramp": 0.0,
    # MEASURED 2026-08-18: `fwd 55 10 0.83` covered 1.70m in 10s.
    # Stored WITH the duty it was measured at, because this project has twice been burnt by
    # a calibration silently outliving the conditions it was taken under. If _BASE_PWM is
    # changed and this is not re-measured, the mismatch is logged at startup rather than
    # quietly corrupting every distance in the run.
    # MEASURED 2026-08-18 with field_test.py at PWM 55, two runs solved together so the startup
    # dead-time is separated from the steady speed rather than smeared into it:
    #     fwd 55 30 0.83 -> 5.00m     fwd 55 10 0.83 -> 1.70m
    #     => speed = 0.165 m/s, startup = -0.30s
    # The previous 0.170 was an observation, not a measurement, and was only 3% out — so the
    # speed constant was NOT the cause of the old "commanded 5m, drove 7m" overrun. That run was
    # at PWM 77 against a constant of 0.161 while the true speed was ~0.225 (ratio 0.72, which is
    # exactly the overrun seen), and the PWM change already fixed it.
    "creep": 0.165, "creep_pwm": 55,
}
# Synced 2026-08-16 to the numbers actually validated on soil with field_test.py —
# this block had drifted and the Seed tab was running stale calibration:
#   ltrim   0.75 -> 0.83   (also matches LEFT_TRIM above; there were THREE values)
#   speed   0.616 -> 0.628
#   startup 0.104 -> 0.099
#   tstartup -0.75 -> -0.80
#   tdps    51.0 -> 45.2   <- see below, this one is not a fresh measurement
#
# On tdps: the operator found `turn=125` produced a correct row change on the ground,
# validated by the two rows actually coming out parallel — better evidence than any of
# the single-angle fits before it. turn=125 @ tdps=62.8 commands -0.80 + 125/62.8 =
# 1.190s, so tdps = 90/(1.190+0.80) = 45.2 makes `turn=90` command that SAME 1.190s.
# Identical motor behaviour, but the geometry stays honest, so uturn/plan/Seed-tab all
# inherit the correction instead of each needing its own fudge.
#
# This is still an OPEN-LOOP timed pivot and it will keep drifting with the surface —
# a skid-steer point turn rotates by scrubbing the wheels sideways, so hard floor and
# loose tilth genuinely differ. The fix is closed-loop heading from a gyro, not a
# better constant. See docs/farm-os/drive-precision.md.


# ── Diagnostics: what THIS side last sent ──────────────────────────────────
# The Diag tab traces one command end to end (browser → console → MCU → driver
# pins → motor current). Stages 3-5 come from the MCU's getDiag; this records
# stage 2, so a mismatch pins the break to a specific hop.
_last_cmd = {"src": None, "direction": None, "left": None, "right": None,
             "speed": None, "at": None}


def _drive(left, right, src, direction=None):
    """Every motor command goes through here so Diag always has the real value."""
    _last_cmd.update(src=src, direction=direction, left=left, right=right,
                     speed=_speed, at=time.time())
    Bridge.call("setMotors", left, right)


def _drive_stop(src):
    _last_cmd.update(src=src, direction="stop", left=0, right=0,
                     speed=_speed, at=time.time())
    Bridge.call("stop")

DIRECTIONS = {
    "forward":  lambda s: trimmed( s,  s),
    "backward": lambda s: trimmed(-s, -s),
    "left":     lambda s: trimmed(-s,  s),      # pivot, in place
    "right":    lambda s: trimmed( s, -s),      # pivot, in place
}


def on_motor_cmd(client, data):
    direction = data.get("direction", "")
    fn = DIRECTIONS.get(direction)
    if fn:
        left, right = fn(_speed)
        _drive(left, right, "drive", direction)


def on_motor_stop(client, data):
    _drive_stop("drive")


def on_set_speed(client, data):
    global _speed
    _speed = max(60, min(255, int(data.get("speed", 180))))


def on_shutdown(client, data):
    Bridge.call("stop")          # stop motors before powering down
    _helper_request("shutdown")

def on_reboot(client, data):
    Bridge.call("stop")
    _helper_request("reboot")

def on_connect_wifi(client, data):
    _helper_request("wifi")      # switch to home WiFi (reverts to hotspot on fail)

def on_start_hotspot(client, data):
    _helper_request("hotspot")   # force the FarmOS-AP hotspot


# ── Seeder ──────────────────────────────────────────────────────────────────
# The timed seconds-based single-row mode was removed: it predated the calibrated
# drive model and expressed spacing as a duration, so it could not hold real
# spacing. Plot seeding (see the plot_* handlers below) replaces it — it plans in
# metres and drives a serpentine with the calibrated dead-time/coast models.
def on_plant_once(client, data):
    """Manual single plant (test button) — refused while a plot run is active."""
    if _run["state"] in ("running", "paused"):
        return
    Bridge.call("plantSeed")


# ── Soil sensing (Stage 2) ──────────────────────────────────────────────────
# Reads the three DIY probes over RPC and logs samples to SQLite (schema shared
# with tests/test_soil_log.py). NOTE: getTemperature blocks ~750ms (DallasTemp),
# so the UI polls soil ONLY while the Soil tab is open — never in the 2s stats.
# GPS lat/lng are NULL until a getGPS RPC lands (BN-880 not yet exposed).
SOIL_DB = os.path.expanduser("~/farm_os.db")
SOIL_SCHEMA = """
CREATE TABLE IF NOT EXISTS soil_readings (
    id INTEGER PRIMARY KEY AUTOINCREMENT,
    timestamp TEXT NOT NULL, lat REAL, lng REAL,
    moisture_a0 INTEGER, moisture_a1 INTEGER, temp_c REAL, ec_raw INTEGER
);
"""
_soil = {"surveying": False, "interval_s": 5}
_soil_thread = None

def _decode(v):
    return v.decode() if isinstance(v, bytes) else v

def _soil_conn():
    conn = sqlite3.connect(SOIL_DB)
    conn.execute(SOIL_SCHEMA)
    conn.commit()
    return conn

def _moist_pct(raw):
    # rough map: dry ≈ 12000, wet ≈ 4000 (14-bit ADC; lower = wetter)
    if raw is None:
        return None
    return max(0, min(100, round((12000 - raw) / (12000 - 4000) * 100)))

def read_soil():
    """Unified read of all three probes; each field is None on read failure."""
    try:
        moist = json.loads(_decode(Bridge.call("getMoisture")))
    except Exception:
        moist = {}
    try:
        temp = float(_decode(Bridge.call("getTemperature")))
        if temp <= -100:            # -127 = no DS18B20 found
            temp = None
    except Exception:
        temp = None
    try:
        ec = int(_decode(Bridge.call("getEC")))
    except Exception:
        ec = None
    a0, a1 = moist.get("a0"), moist.get("a1")
    return {
        "moisture_a0": a0, "moisture_a1": a1,
        "moist_pct_0": _moist_pct(a0), "moist_pct_1": _moist_pct(a1),
        "temp_c": temp, "ec_raw": ec,
    }

def _log_soil(r, lat=None, lng=None):
    conn = _soil_conn()
    conn.execute(
        "INSERT INTO soil_readings (timestamp,lat,lng,moisture_a0,moisture_a1,temp_c,ec_raw) "
        "VALUES (?,?,?,?,?,?,?)",
        (datetime.now(timezone.utc).isoformat(), lat, lng,
         r["moisture_a0"], r["moisture_a1"], r["temp_c"], r["ec_raw"]),
    )
    conn.commit()
    n = conn.execute("SELECT COUNT(*) FROM soil_readings").fetchone()[0]
    conn.close()
    return n

def _soil_count():
    try:
        conn = _soil_conn()
        n = conn.execute("SELECT COUNT(*) FROM soil_readings").fetchone()[0]
        conn.close()
        return n
    except Exception:
        return 0

def on_get_soil(client, data):
    r = read_soil()
    r["surveying"] = _soil["surveying"]
    r["logged"] = _soil_count()
    ui.send_message("soil", r)

def on_soil_sample(client, data):
    r = read_soil()
    n = _log_soil(r)
    r["logged"] = n
    r["sampled"] = True
    ui.send_message("soil", r)

def _survey_loop():
    try:
        while _soil["surveying"]:
            _log_soil(read_soil())
            # sleep in chunks so Stop is responsive
            end = time.time() + _soil["interval_s"]
            while time.time() < end and _soil["surveying"]:
                time.sleep(0.1)
    finally:
        _soil["surveying"] = False

def on_survey_start(client, data):
    global _soil_thread
    _soil["interval_s"] = max(2, int(data.get("interval_s", _soil["interval_s"])))
    if _soil["surveying"]:
        return
    _soil["surveying"] = True
    _soil_thread = threading.Thread(target=_survey_loop, daemon=True)
    _soil_thread.start()

def on_survey_stop(client, data):
    _soil["surveying"] = False


# ── Camera + vision (Stage 5) ────────────────────────────────────────────────
# The UNO Q is the SINGLE consumer of the ESP32-CAM stream (the cam is weak and
# chokes serving two clients — that was the browser lag). One background loop
# reads frames, runs detect_tube/detect_emitter at full rate, steers+plants in
# drip mode, AND — only while the Camera tab is open — pushes annotated JPEG
# frames to the browser over the socket at a throttled rate. The browser never
# touches the cam directly.
_cam = {"url": "", "w": 0, "h": 0, "tube": None, "emitter": None, "watch": 0.0,
        "last_frame": 0.0}          # monotonic-ish stamp of the last SUCCESSFUL read
# How long without a decoded frame before the stream counts as dead. The ESP32-CAM's
# MJPEG stream can stop delivering while the socket stays open — read() then returns
# False forever and the loop livelocks: thread alive, nothing arriving. See _cam_loop.
_CAM_STALE_S = 5.0
_CAM_REOPEN_TRIES = 3
# Drip seeding (Act 3). The trigger is the CAMERA, not odometry: plant at each
# emitter the model finds. `emitter_gap` is the operator's APPROXIMATE spacing —
# it isn't used to place seeds, only to (a) reject a second detection of the same
# emitter and (b) estimate counts/time for the UI.
# The seeder arm carries 2 outlets 180° apart and one solenoid fires both, so a
# single plantSeed drops 2 seeds. `angle` rotates that pair: 0° lays them along
# the drip line, 90° across it. The opposite outlet always lands at angle+180.
# `angles` are ARM POSITIONS to plant at, in order. Each one drops 2 seeds (the
# two outlets are 180 deg apart and one solenoid fires both), so [0, 90] plants a
# 4-seed cross per emitter: 0/180, then rotate, then 90/270.
_drip = {"emitter_gap": 0.40, "angles": [0, 90],
         # Multi-lateral (Act 3 extension). laterals=1 keeps the original behaviour:
         # one row, then done. >1 makes the robot SEARCH for the next lateral rather
         # than compute where it should be — turn off the row, drive across until the
         # camera sees a crossing tube, turn onto it. That needs no row spacing and no
         # assumption that the laterals are parallel, which real drip layouts rarely are.
         "laterals": 1}
# Between-lateral search tuning.
_TRAVERSE_MIN_M   = 0.10   # ignore crossings until this far off the old row.
                           # WAS 0.60, as a guard against re-latching onto the lateral we
                           # just left. It cost us the row change on 2026-08-17: the real
                           # next lateral was seen at 0.34m and 0.53m, steady and strong,
                           # and BOTH were discarded as "still inside min-traverse" — the
                           # robot then turned onto something at 0.82m. Two reasons this
                           # is now 0.10:
                           #   * the distance it gates on is time x an unmeasured creep
                           #     speed, so it is not trustworthy at this scale anyway;
                           #   * the guard has never actually been needed. After the
                           #     90 deg turn the old row is behind the robot, and every
                           #     run logs found=False for the first samples (0.00m, 0.17m)
                           #     — the camera looks ahead and simply does not see it.
                           # 0.10 keeps a floor against detecting the old row in the very
                           # first frames while the robot is still sitting on it.
_TRAVERSE_NEAR    = 0.60   # `nearness` at which the tube is close enough to turn onto
# TURN ON APPROACH, NOT ON A SINGLE GOOD FRAME. The 03:33 run detected crossings at
# nearness 0.53, 0.39, 0.91, then 0.08, 0.06, 0.19 and never turned: the old rule wanted
# three CONSECUTIVE frames agreeing within 40px, and one dropped frame reset the count to
# zero every time. But a lateral the robot is driving towards has a signature no soil
# artefact has — it moves steadily DOWN the frame. So instead of demanding consecutive
# agreement, keep a short history and require the trend: several sightings within a couple
# of seconds whose y has grown. Dropouts no longer reset anything; they just thin the
# history.
#
# RE-EXPRESSED IN DISTANCE, 2026-08-18. The old rule was "4 sightings within 2.5s, y grown
# 25px". At 1.4fps a 2.5s window held ~3.5 frames, so "4 sightings" demanded essentially
# EVERY frame agree — a strong test. At 30fps the same window holds 75 frames, so it asks for
# a 5% hit rate, and 25px of growth over 42cm of driving is 2.3cm of approach, which sensor
# noise clears on its own. The gate that decides the robot turns onto a row had become close
# to free to satisfy, and it is not recoverable by a later frame: turn onto the wrong thing
# and the run is over.
#
# So: a window measured in METRES DRIVEN, sightings as a FRACTION of the frames in it, and
# the growth checked against what the geometry says it should be. A lateral the robot is
# driving at sweeps down the frame at _PX_PER_M_DEPTH px per metre; soil artefacts do not
# advance with distance at all. Requiring a quarter of the geometric expectation is loose
# enough for a noisy band and still rejects anything static.
_TRAVERSE_WINDOW_M       = 0.35   # trailing distance that counts as "recent"
_TRAVERSE_MIN_SIGHT_FRAC = 0.35   # of the frames in that window
_TRAVERSE_MIN_SIGHTS     = 3      # absolute floor, so 1-of-2 frames cannot pass on fraction
_TRAVERSE_APPROACH_FRAC  = 0.25   # of the growth the geometry predicts for the distance
_TRAVERSE_APPROACH_PX_MIN = 6     # absolute floor, kept as a guard (see below)
# MINIMUM GROUND OVER WHICH THE BAND MUST HAVE BEEN WATCHED before approach is judged at all.
# Without this the scaled requirement collapses to its px floor over a very short span, and a
# unit test caught the consequence: three sightings 3mm apart with 6px of sensor wobble
# satisfied "grew >= need_px" exactly and the latch fired. The answer is not a bigger px floor
# but refusing to answer — 3mm of driving is not evidence about anything. At 5cm the geometry
# predicts 54px of sweep, so the requirement becomes 14px and noise cannot reach it.
_TRAVERSE_MIN_SPAN_M     = 0.05
#
# NOTE the requirement GROWS with the sighting span and is deliberately NOT capped. Capping it
# would make a longer observation an easier test, which is backwards: the longer we have been
# watching something, the more it must have moved to still be a lateral we are driving at.
# Sanity check on the numbers — we latch at nearness 0.60, i.e. y=144, so a band tracked from
# the top of frame gives a span of about 144/1090 = 0.13m and a requirement of 36px against
# 144px of real growth. Comfortable margin for a real lateral; a static artefact grows 0.
_ARM_DWELL_S  = 0.6
# plantSeed on the MCU is drop(500) + settle(100) + punch(500) + fill(400) = 1.5s.
# A dry run sleeps the same so its timing matches a real run.
_PLANT_SIM_S  = 2.0      # let the spool servo reach the angle before dropping
_MIN_REPLANT_M = 0.08    # absolute floor; see _min_replant() for the run-time value

# THE WHOLE EMITTER ALGORITHM, and it is the operator's design: watch a LINE near the bottom of the
# frame, and commit an emitter the moment something crosses below it. Drive the measured distance to
# the punch. Repeat. At most two emitters pending at once.
#
# WHY THREE EARLIER ATTEMPTS FAILED, all in the same place. The punch sits 0.39 m BEHIND the nearest
# ground the camera can see, so at the moment of acting the emitter is invisible and has been for
# 0.39 m. That forces memory and odometry — and then IDENTITY, because one emitter is seen on ~10
# frames and must be punched once, so something must decide "is this the same emitter as that one?"
# A per-frame detector has no opinion on that, and every bug was an identity error:
#
#     re-arm on visibility       -> "is it gone?" never true; view (0.43 m) wider than spacing (0.40 m)
#     blind creep to the punch    -> consumed a whole spacing unseen, planted every other emitter
#     best-confidence box         -> reported the FAR emitter, hid the near one in the reach zone
#     target dedupe + refinement  -> refinement dragged two targets inside the dedupe distance, and
#                                    nothing re-checked them: the 08:04 run punched 0.97 m and 0.98 m
#
# NOT ONE was a detection failure. The model has been right since the retrain — it says "emitter"
# reliably on ~100% of frames. What it cannot say is WHICH emitter, and this design never asks.
#
# A RISING EDGE IS THE IDENTITY. "Is anything below the line" goes false->true exactly once per
# emitter, because the line genuinely clears in between. At the demo's 0.40 m spacing:
#     A occupies the line for travelled in [A-0.455, A-0.39]   -- 6.5 cm
#     B arrives at A-0.055
#     => the line is CLEAR for 33.5 cm between them
# So there is no dedupe, no refinement and nothing to drift.
#
# WHY THE LINE IS NOT THE BOTTOM EDGE. Leaving the frame would be the crispest event, but when A is
# punched B sits only 1 cm above the bottom edge — about two frames of observation, and one dropout
# loses it below the frame for good. y >= 0.85 h puts the line at gap 0.455 m, giving 6.5 cm (~12
# frames at 30 fps) of window.
#
# WHY TWO PENDING AND NOT ONE. B crosses the line 5.5 cm BEFORE A is punched, i.e. while A is still
# pending. With capacity 1 that crossing is discarded and B can only be caught in the 1 cm between
# A's punch and B leaving the frame — about two frames. Capacity 2 lets B commit on its own crossing,
# with the full window. Three would never be used at any plausible spacing.
_EMIT_MAX_PENDING = 2
# How deep below the frame's near edge the commit band reaches, capped and also held under the
# emitter spacing so only ONE emitter is ever inside it. 0.23 m is ~42 frames of observation at
# 30 fps and 0.165 m/s.
# NARROWED 0.23 -> 0.10 m, from the measured y-noise. The run of 08:44 committed 17 targets for 12
# real emitters (measured with a tape: 12 at 40 cm), and the target gaps were 0.17-0.32 m — far too
# close together to be different emitters. So one emitter was being committed repeatedly at DIFFERENT
# estimated positions, which is the y-noise: the field log shows the reported row moving 150 -> 108
# between two frames of the SAME emitter, and 42 px is 7.5 cm of ground.
#
#     apparent residence window  ~=  band depth + 2 x jitter
#     with a 0.23 m band          =  0.23 + 0.15 = 0.38 m  -> exceeds the 0.28 lockout, so an
#                                    emitter is still "in the band" when the lockout expires
#     with a 0.10 m band          =  0.10 + 0.15 = 0.25 m  -> under a 0.30 m lockout
#
# A 0.10 m band still gives ~18 frames at 30 fps to see the emitter, and it sits at gap 0.39-0.49 —
# nearest the camera, where the y-to-distance interpolation error is smallest.
_EMIT_BAND_M = 0.10
_EMIT_BAND_FRAC_OF_GAP = 0.25



# AN EMITTER IS PART OF THE TUBE, SO IT MUST BE ON THE TUBE. This is the gate that matters, and it
# was missing entirely.
#
# WHAT IT FIXES. Pointed at ordinary leaf litter with NO tube and NO emitter in frame at all, the
# retrained model reported boxes at confidence 0.93, 0.65 and 0.52. Sampled over 60 frames of that
# litter it produced 145 boxes. So "an emitter is in the band" was very nearly always true, and every
# counting scheme built on it — four of them — degenerated into being paced by whatever lockout I had
# set rather than by emitters. The 08:35 run's commits sat at 0.28-0.29 m, exactly my lockout.
#
# The earlier false-positive check passed 0 of 17 and gave false comfort: those negatives were bare
# soil and crossing laterals. LEAF LITTER was in neither the training set nor the test set.
#
# WHY THIS FILTER IS CHEAP AND STRONG. The tube detector already tracks the tube's column, and an
# emitter is a fitting ON that tube — it cannot be 20 cm off to the side in the litter. Measured on
# the same 60 litter frames: of 145 boxes, 138 were on frames where no tube was found at all and are
# rejected outright, and only 3 survived a +/-40 px window. That is ~98% of the false positives gone
# for two comparisons per box.
#
# THE WINDOW IS DERIVED FROM THE TUBE'S OWN MEASURED WIDTH, not picked. A flat 30 px was 6x the
# tube's half-width (fwhm 9-11 px on a 16 mm tube), i.e. it accepted anything within 5 cm of the
# tube — which is not "on the tube" in any useful sense.
#
# half the measured fwhm, plus room for the outlet sticking out sideways and for detection jitter.
_EMIT_ON_TUBE_MARGIN_PX = 12.0
_EMIT_ON_TUBE_FALLBACK_PX = 18.0     # when the tube reports no usable width


def _tube_x_at(tube, y, h):
    """The tube's column AT ROW y, not at the bottom of frame.

    THIS IS THE FIX THE OPERATOR ASKED FOR TWICE. Comparing an emitter box against x_near — the
    tube's column at the BOTTOM of frame — is only right for a perfectly vertical tube. The detector
    accepts tilts up to 35 degrees, and the tube's column shifts across the frame with tilt:

        tilt  5 deg -> tube x differs by  21 px top to bottom
        tilt 15 deg ->                    64 px
        tilt 25 deg ->                   112 px

    So on a 15 degree tube a REAL emitter at mid-frame sits 32 px away from x_near, and a ~17 px gate
    would throw it away — while happily accepting litter on the other side of the tube. The detector
    already reports both ends, so interpolate.
    """
    try:
        far = float(tube.get("x_far"))
        near = float(tube.get("x_near"))
    except (TypeError, ValueError):
        return None
    if not h:
        return near
    f = max(0.0, min(1.0, float(y) / float(h)))     # 0 = top of frame, 1 = bottom
    return far + f * (near - far)


def _emit_on_tube_px(tube):
    """How far off the tube column an emitter box may sit and still be on the tube."""
    w = tube.get("width_fwhm") if tube else None
    try:
        w = float(w)
    except (TypeError, ValueError):
        w = None
    if not w or w <= 0:
        return _EMIT_ON_TUBE_FALLBACK_PX
    return 0.5 * w + _EMIT_ON_TUBE_MARGIN_PX


def _emit_lockout_m():
    """Distance that must pass between two commits. THE ONLY THING SEPARATING EMITTERS.

    Must exceed the band depth (0.55 x gap) so one emitter cannot commit twice, and stay under the
    real spacing so the next emitter is not skipped. 0.70 x gap sits between them. Derived from the
    CONFIGURED emitter_gap, which is therefore the setting that matters most for the count.
    """
    gap = float(_drip.get("emitter_gap") or 0.0)
    # 0.75 x spacing: above the apparent residence window (band + 2 x jitter ~= 0.25 m at a 0.40 m
    # spacing) so one emitter cannot commit twice, and below the spacing so the next is not skipped.
    return max(0.15, 0.75 * gap) if gap else 0.30


def _emit_band_m():
    """Depth of the commit band, kept under the emitter spacing so one emitter occupies it at a time.

    That single property is what makes a rising edge equal one emitter, which is what removes the
    need to decide WHICH emitter a detection belongs to — the mistake behind every earlier attempt.
    """
    gap = float(_drip.get("emitter_gap") or 0.0)
    return min(_EMIT_BAND_M, _EMIT_BAND_FRAC_OF_GAP * gap) if gap else _EMIT_BAND_M


def _min_replant():
    """Distance that must pass before the NEXT emitter can be planted.

    A SAFETY FLOOR ONLY, and with the commit-band design it should never bind: one emitter produces
    one rising edge, so there is nothing to deduplicate. The `armed` edge-detect that used to do the
    debouncing is gone: it keyed off whether an emitter was still VISIBLE, and with the camera's view
    (0.43 m) wider than the emitter spacing (0.40 m) there is essentially always one in frame, so it
    never re-armed and a 5 m lateral planted once.

    Still not a trigger — the model decides where emitters are, and a missed one just
    means the next is found normally. This only stops ONE emitter being counted twice,
    which the 03:33 run did: stops at 2.73m and 2.84m, 11cm apart on a line whose
    emitters sit 40cm apart, because the emitter left the frame during a tube dropout
    and re-armed on the way back in. Half the operator's spacing is comfortably below
    any real gap and comfortably above that.
    """
    gap = float(_drip.get("emitter_gap") or 0.0)
    return max(_MIN_REPLANT_M, 0.5 * gap) if gap else _MIN_REPLANT_M


def _traverse_track(hist, traversed, cross):
    """Add this frame to the crossing history and decide whether one is APPROACHING.

    Pure and side-effect free (it returns a new history) specifically so the latch that
    decides the robot turns onto a row can be unit-tested. It could not be before: it lived
    inline in the camera loop, which needs a board, so the only way to exercise it was a
    field run — and a field run is exactly where a wrong answer is expensive.

    Returns (history, info).

    EVERY frame goes into the history, sighting or not, so the sighting FRACTION is
    measurable. The old history kept only sightings, which is why 4-of-75 frames looked
    identical to 4-of-4 and the test silently weakened by 20x when the camera got faster.
    """
    hist = list(hist)
    hist.append((traversed, cross["tube_y"] if cross["found"] else None))
    hist = [s for s in hist if traversed - s[0] <= _TRAVERSE_WINDOW_M]
    sights = [s for s in hist if s[1] is not None]
    frac = len(sights) / float(len(hist)) if hist else 0.0
    span_m = (sights[-1][0] - sights[0][0]) if len(sights) >= 2 else 0.0
    grew = (sights[-1][1] - sights[0][1]) if len(sights) >= 2 else 0.0
    # What the geometry says a real approaching lateral must have moved over span_m. A band
    # that is really coming towards the robot sweeps down the frame at _PX_PER_M_DEPTH px per
    # metre driven; a shadow or a straw does not advance with distance at all.
    need_px = max(_TRAVERSE_APPROACH_PX_MIN,
                  _TRAVERSE_APPROACH_FRAC * span_m * _PX_PER_M_DEPTH)
    approaching = (len(sights) >= _TRAVERSE_MIN_SIGHTS
                   and span_m >= _TRAVERSE_MIN_SPAN_M
                   and frac >= _TRAVERSE_MIN_SIGHT_FRAC
                   and grew >= need_px)
    return hist, {"approaching": approaching, "sights": len(sights),
                  "frames": len(hist), "frac": frac, "grew": grew,
                  "span_m": span_m, "need_px": need_px}


def _traverse_max():
    """How far to search for the next lateral before giving up.

    Was a flat 4.0m, which at the current speed estimate is nearly 6m of real ground —
    the robot drives that far with nothing in view, which reads as a runaway. The
    operator has already told us how far apart the rows are, so allow three of them.
    """
    return max(1.5, 3.0 * float(_plot.get("row_gap") or 0.7))
# Emitter-model rate limit. See the camera loop for why this is not once per frame.
# How old a frame may be and still be acted on. At 0.22 m/s the robot covers ~4cm in
# 200ms; beyond that the view no longer describes where it is. Before the frame bus there
# was no timestamp at all, so a 2s-old buffered frame was indistinguishable from a live one
# and got steered on — the silent half of the stale-frame problem.
_FRAME_MAX_AGE_S = 0.25   # unused: superseded by bus.stale_after(), which MEASURES the
                          # camera's real frame interval instead of assuming one
# INFERENCE RUNS ON ITS OWN THREAD (vision/emitter_worker.py), so this number no longer means
# what its predecessor _EMIT_TTL_S meant, and the difference is the whole point of Phase 3b.
#
# _EMIT_TTL_S was a STALENESS BUDGET that the control loop paid for: at every expiry the
# steering loop stopped for 80ms to run a model steering does not use, and in between it reused
# an old answer while 9 fresher frames sat unexamined on the bus.
#
# This is a THROTTLE ON THE ACCELERATOR, which the control loop does not pay for at all. Left
# at 0 the worker would run flat out and keep the inference container continuously busy for a
# result the robot only needs while an emitter is in the reach band. Sizing it: that band is
# the bottom 45% of the frame, ~108px, which at the measured 1090 px/m is ~10cm of ground and
# ~0.6s of travel — so 0.15s gives four independent looks inside the window that matters.
#
# 0.15 -> 0.25 after the first field run MEASURED the cost. The log reported inference at
# 85-96ms (I had estimated 70-90) and the control loop at 18-20 fps against a camera delivering
# 29.7 — so roughly a third of the frames were going unprocessed. At 0.15s that is ~60% duty on
# the worker, and although it runs on its own thread it still contends for the GIL and shares the
# process with the JPEG encode. Threading removed the BLOCKING, not the CPU cost.
#
# 0.25s is ~36% duty. It costs emitter looks inside the reach band — ~2.4 per emitter instead of
# ~4 — which is why _EMIT_CONF was lowered to 0.80 in the same breath, and why the fresh
# re-confirm at the plant stop exists to recover the precision. Steering needs the frames more:
# it is the thing that keeps the robot on the row at all.
_EMIT_MIN_INTERVAL_S = 0.25
# How far out of date the box may be before the creep distance stops trusting it. The box now
# carries the CAPTURE TIME of its frame, so this is checked against measured age rather than
# against when inference happened to start.
_EMIT_MAX_STALE_M = 0.02
_cam_thread = None
_BROWSER_FPS = 6                    # annotated frames/s pushed to the browser
_WATCH_TTL   = 2.0                 # keep pushing this long after the last get_vision poll

# Dataset capture: save RAW frames at an interval while driving the drip line,
# to build the emitter-model training set. Start/stop + verify from the UI.
# Saved under the app dir (mounted to the host ~/motor-control/captures) so they
# PERSIST across container restarts and are pullable from the host.
_CAP_DIR = os.path.abspath(os.path.join(os.path.dirname(__file__), "..", "captures"))
_capture = {"on": False, "interval": 2.0, "count": 0, "last": 0.0}

# drip-follow tunables (mirror vision/tube_follow.py)
# CREEP SPEED IS SET BY THE CAMERA, NOT BY THE MOTORS.
# The camera delivers ~1.4 fps (measured 2026-08-18 with curl straight to it, robot app
# stopped: 11 frames in 8s), so a new measurement arrives every ~710ms. At PWM 77 that is
# 16cm of ground per control update, against a lookahead of ~62cm — a quarter of the
# lookahead consumed blind between corrections, which no gain can stabilise. It also lets
# the robot step clean over the band where an emitter counts as "in reach".
#
# PWM 55 roughly halves that. UNMEASURED: the speed at this duty has not been checked, and
# the two numbers below depend on it —
#   1. _DRIP_SPEED_MPS (distance tracking) was observed at PWM 77 and is now WRONG
#   2. low duty risks stiction; if the robot stalls or crawls unevenly on soil, raise it
# Measure both with:  field_test.py fwd 55 10 0.83   -> metres/10 = m/s
_BASE_PWM = 55
_CAL_PWM  = 77            # the duty _DRIP_SPEED_MPS was observed at
# Threshold on the model's RAW value (see emitter_ml: the old 0.6 scaling plus a bogus moisture
# bonus made 0.55 mean "ml >= 0.25").
#
# 0.90 -> 0.80 on 2026-08-18, for two reasons.
#
# FIRST, 0.90 WAS SET ON MISREAD EVIDENCE. It was chosen to reject three "false positives on
# plain tube" scoring 0.57 / 0.77 / 0.87 — and at least one of those frames CONTAINED REAL
# EMITTER HOLES. They are 4-6px features, invisible at full-frame zoom, and the frame was judged
# without cropping in. So the gate was pushed above a detection that was actually correct.
#
# SECOND, the retrained model measures differently. On 298 held-out frames from the dense pass,
# detections inside the reach band (y >= _EMIT_MIN_Y_FRAC) have a MEDIAN of 0.843 — so 0.90 sits
# above the median of the readings the plant trigger acts on:
#     gate 0.90 -> 19/298 frames qualify  (~3 qualifying frames per emitter over a full pass)
#     gate 0.80 -> 40/298                 (~8 per emitter)
# Three frames per emitter is enough for the edge-triggered plant to fire once, but there is
# almost no margin, and a missed emitter is a skipped seed while a false positive is one wasted
# seed. The costs are not symmetric.
#
# 0.80 -> 0.60 on 2026-08-19, and this time against A FIELD RUN rather than a distribution. The
# note that used to sit here predicted the failure exactly: "too high shows up as the robot walking
# past emitters". It did. A 5m lateral with emitters every 0.40m — about 12 — stopped at TWO.
#
# The per-window emitter tally is what made it legible, and it is worth reading as the model's
# confidence histogram on THIS camera:
#
#     window   frames with a box   passed 0.80   best conf
#      1/1                              1        0.94  y=204   -> stopped
#      7/93                             0        0.78  y=168
#     14/95                             0        0.54  y=78
#      1/4                              1        0.92  y=222   -> stopped
#      0/92     model returned NOTHING on 92 consecutive frames
#     13/95                             0        0.67  y=210
#
# TWO THINGS FOLLOW. The distribution is BIMODAL — 0.92-0.94 or 0.54-0.78, with nothing between
# 0.80 and 0.92 — so 0.80 sat exactly in the empty band and admitted only the top mode. And the
# 92-frame silent window is the control: on plain tube between emitters the model reports nothing
# at all, so the mid-confidence boxes are not noise. It is under-confident, not wrong.
#
# WHY UNDER-CONFIDENT: the model was trained on Logitech C310 frames. The robot now has a
# QHM-999RL — different lens, different field of view (0.43m of ground against the C310's 0.22m),
# different colour rendering. The held-out median of in-reach detections was 0.843 on C310 frames;
# the best-per-window figures above are 0.54-0.78. That is a systematic downward shift, which is
# what a domain change looks like.
#
# So 0.60 is a STOPGAP with a real fix behind it: retrain on frames from this camera. It is the
# right stopgap because the costs are asymmetric — a missed emitter is a skipped seed, a false
# positive is one wasted seed — and because in DRY mode a false stop costs nothing at all.
#
# VALIDATE IT THE SAME WAY: every stop saves an emitN_latM frame. Look at them. Stops on bare tube
# mean 0.60 is too low; a count near 12 on a 5m lateral with all frames on real emitters means it
# is right. Do not raise it again on a distribution.
_EMIT_CONF, _EMIT_COOLDOWN = 0.60, 3.0
# WHERE in frame the emitter must be before we stop for it. The camera looks down AND
# ahead, so an emitter first appears near the TOP of the frame — a metre or more away.
# Confidence alone as the trigger meant the robot stopped the instant each emitter
# entered view, at a different distance every time, and would have dropped seed nowhere
# near the emitter. Lower in frame = nearer, so hold off until the detection's centre is
# below this fraction of the frame height.
_EMIT_MIN_Y_FRAC = 0.55


# WHERE THE PUNCH IS, RELATIVE TO WHAT THE CAMERA CAN SEE:
#     punch tip -> front wheel centre    16 cm   (seeder is centre-mounted; tip sits 3cm
#                                                 behind the pivot axis)
#     front wheel -> bottom of frame     23 cm   (operator measured 24 cm on the new camera)
#     bottom of frame -> top of frame    43 cm   <- CORRECTED 2026-08-19
# So the visible strip is 39-82 cm AHEAD OF THE PUNCH. An emitter under the tip is invisible:
# it left the frame 39 cm ago.
#
# THE FAR EDGE WAS 0.61 AND THAT WAS A C310 NUMBER. Its comment recorded "bottom of frame -> top
# of frame 22 cm", the old camera's strip; the QHM-999RL sees 43 cm, so the far edge is
# 0.39 + 0.43 = 0.82. The error only mattered once the retrained model started detecting away from
# the very bottom, where the two agree — at which point it under-estimated the creep by 7 cm at
# y=162, 10 cm at mid-frame and 18 cm at y=30, all of which the model now reaches.
_PUNCH_TO_FRAME_NEAR_M = 0.39
_PUNCH_TO_FRAME_FAR_M  = 0.82


def _emitter_ground_m(emit, h):
    """Metres from the PUNCH TIP to a detected emitter, or None.

    Maps the detection's row in the image to a ground distance by linear interpolation
    between the two measured frame edges. Ignores perspective, which over a 22cm strip from
    an 18cm-high camera costs about 3cm at mid-frame (~13% of the span) — acceptable for
    dropping a seed beside an emitter, and it is why the trigger prefers detections near the
    BOTTOM of the frame, where both the interpolation error and the creep distance are least.
    To do better, calibrate y-to-distance with an object at two known distances.
    """
    pos = emit.get("position")
    if not pos or not h:
        return None
    frac = max(0.0, min(1.0, pos[1] / float(h)))     # 0 = top of frame, 1 = bottom
    return _PUNCH_TO_FRAME_FAR_M - frac * (_PUNCH_TO_FRAME_FAR_M - _PUNCH_TO_FRAME_NEAR_M)


# WHAT THE EMITTER MODEL ACTUALLY REPORTED, per status window. Added 2026-08-19 after a run did
# 125 inferences down a 5m lateral and stopped at ZERO emitters — with no way to tell which of
# three things had happened:
#
#     the model returned nothing at all              -> retrain, or the wrong model is bound
#     it returned boxes below _EMIT_CONF (0.80)      -> lower the gate, or retrain
#     it returned confident boxes too HIGH in frame  -> _EMIT_MIN_Y_FRAC / geometry, not the model
#
# Three completely different fixes, and the log could not separate them. Two days of emitter
# changes were made without this, which is exactly why they kept missing. detect_emitter_ml asks
# the model with conf_min=0.3, so sub-threshold boxes DO come back and can be counted — the
# information existed and was simply thrown away every frame.
_emit_tally = {"frames": 0, "detected": 0, "conf_ok": 0, "reach_ok": 0,
               "best_conf": 0.0, "best_y": None, "best_frame": None,
               # how the ON-THE-TUBE filter is doing. This is the measurement that decides whether
               # the emitter false positives are litter beside the tube or something on the tube
               # itself, which is currently unknown.
               "no_tube": 0, "off_tube": 0, "offsets": [],
               # WHY a box did not become a stop. Every emitter debugging session so far has been
               # blocked on exactly this: the log said how many boxes there were, never what happened
               # to them. Each counter is one reason, so the dominant one names the fault.
               "blk_conf": 0, "blk_band": 0, "blk_lockout": 0, "blk_full": 0,
               "committed": 0, "commit_gaps": []}


def _emit_tally_reset():
    _emit_tally.update(frames=0, detected=0, conf_ok=0, reach_ok=0,
                       best_conf=0.0, best_y=None, best_frame=None,
                       no_tube=0, off_tube=0, blk_conf=0, blk_band=0, blk_lockout=0,
                       blk_full=0, committed=0)
    _emit_tally["offsets"] = []
    _emit_tally["commit_gaps"] = []


def _emit_tally_add(emit, in_view, detected, h):
    """Record one frame's emitter observation against each gate in turn."""
    _emit_tally["frames"] += 1
    if not emit.get("detected"):
        return
    _emit_tally["detected"] += 1
    conf = float(emit.get("confidence") or 0.0)
    pos = emit.get("position")
    y = pos[1] if pos else None
    if in_view:
        _emit_tally["conf_ok"] += 1
    if detected:
        _emit_tally["reach_ok"] += 1
    if conf > _emit_tally["best_conf"]:
        _emit_tally.update(best_conf=conf, best_y=y)


def _emit_tally_line(h):
    """One line that says which gate is losing the emitters, or that the model found none."""
    t = _emit_tally
    if not t["frames"]:
        return None
    if not t["detected"]:
        return ("  emitters: model returned NOTHING on %d frames (asked at conf>=0.3). "
                "Either no emitter was in view, or the model cannot see them — check a saved "
                "frame before retraining." % t["frames"])
    blocked = ("  | REJECTED: conf %d, no-tube %d, off-tube %d, outside-band %d, lockout %d, "
               "queue-full %d -> COMMITTED %d%s"
               % (t["blk_conf"], t["no_tube"], t["off_tube"], t["blk_band"], t["blk_lockout"],
                  t["blk_full"], t["committed"],
                  ("  | commit gaps %s" % t["commit_gaps"]) if t["commit_gaps"] else ""))
    offs = sorted(t["offsets"])
    on_tube = len(offs) - t["off_tube"]
    extra = ("  | ON-TUBE FILTER: %d boxes checked, %d on the tube, %d rejected off it, "
             "%d with no tube at all%s"
             % (len(offs), on_tube, t["off_tube"], t["no_tube"],
                (" | box-x minus tube-x  p10 %+d  med %+d  p90 %+d"
                 % (offs[len(offs) // 10], offs[len(offs) // 2], offs[-1 - len(offs) // 10]))
                if len(offs) >= 10 else "")) if (offs or t["no_tube"]) else ""
    reach_px = h * _EMIT_MIN_Y_FRAC if h else 0
    return ("  emitters: %d/%d frames had a box | %d passed conf>=%.2f | %d ALSO low enough "
            "(y>=%.0f) | best conf %.2f at y=%s%s"
            % (t["detected"], t["frames"], t["conf_ok"], _EMIT_CONF, t["reach_ok"], reach_px,
               t["best_conf"], t["best_y"],
               "  <- boxes are too HIGH in frame, not too weak"
               if t["conf_ok"] and not t["reach_ok"] else
               "  <- boxes are below the confidence gate"
               if t["detected"] and not t["conf_ok"] else "") + extra + blocked)


def _emitter_in_reach(emit, h):
    """True when the emitter is low enough in frame to act on.

    No longer means "under the seeder" — it cannot, since the seeder is 39cm behind the
    nearest visible ground. It means "near enough that the creep is short and the distance
    estimate is good", after which _creep() brings it under the tip.
    """
    pos = emit.get("position")
    if not pos or not h:
        return False
    return pos[1] >= h * _EMIT_MIN_Y_FRAC
# Steering, retuned 2026-08-17 after a field run oscillated badly — corrections swung
# +2.9 / -1.0 / +0.2 / -2.0 / -3.2 within a couple of seconds, losing the tube about
# twice a second. Two faults, opposite in sign:
#
#   TOO WEAK at small error — a correction of 0.3 asks for 3 PWM of differential on a
#   base of 77. That does not overcome stiction on soil, so the robot drifts, doing
#   nothing, until the error is large.
#   TOO STRONG at large error — 10 x correction at ~10 fps (the ML detector costs a
#   ~70-90ms round trip) overshoots past centre, and P-only control with that much lag
#   turns drift into a limit cycle.
#
# So: lower the proportional gain, add a floor that actually moves the robot, and use
# the tube's TILT as a damping term. detect_tube has always returned `angle_deg` and
# nothing ever read it — steering on position alone is why it hunts. Tilt says whether
# we are converging or diverging, which is the derivative term this loop lacked.
# GAIN AND FLOOR TOGETHER DECIDE WHETHER THIS IS PROPORTIONAL AT ALL.
# At gain 6 the old command was 6 x err, and real frames give |err| under about 1.8 — so
# the result was below the 11 PWM floor essentially always, and every correction came out
# at exactly +/-11 whatever the error. That is a BANG-BANG controller, which is its own
# source of weaving regardless of how good the measurement is.
# Gain 14 with a floor of 9 puts the proportional region where the errors actually live:
# below err 0.65 the floor still guarantees the robot moves against stiction, and above it
# the command tracks the error. UNVERIFIED IN THE FIELD — these are chosen so a proportional
# band exists, not calibrated.
# Gain and floor are expressed AT _CAL_PWM and scaled to the duty actually in use — a
# differential of 20 PWM on a base of 77 is a gentle correction; the same 20 on a base of
# 55 is a much harder turn, and the same steering command would suddenly oversteer.
_STEER_SCALE    = _BASE_PWM / float(_CAL_PWM)
_STEER_GAIN     = 14 * _STEER_SCALE
_STEER_MIN_DIFF = max(6, int(round(9 * _STEER_SCALE)))
_STEER_DEADBAND = 0.25  # ignore correction noise below this — do not chase pixels
# How much of the error comes from the LOOKAHEAD point rather than the tube at the wheels.
# 0.0 waits until the tube reaches the wheels before correcting; 1.0 ignores lateral offset
# entirely and tracks parallel to the row without ever closing on it.
#
# Retuned 2026-08-18 with the USB camera. Two things changed and they pull the same way:
#   * The near point is genuinely NEAR now — 41cm from the pivot axis, so cross-track error
#     is worth acting on rather than being a stale figure.
#   * The near-to-far baseline shrank from 34cm to 22cm, so `far - near` (the heading signal)
#     is measured over less ground and is correspondingly noisier. Weighting it heavily
#     amplifies that noise.
#   * And at 30fps, frame rate substitutes for lookahead: a correction that is slightly late
#     is re-decided 30 times a second rather than once per 12cm of travel.
# 0.5 splits it evenly. UNVALIDATED IN THE FIELD — start here, and if it tracks parallel but
# offset, lower it; if it hunts, raise it.
_STEER_W_FAR = 0.5
# (The tilt-as-derivative term is gone. far/near carry the same, verified sign convention,
#  and far minus near is the tilt — so the same information arrives without the sign risk
#  that made the earlier angle_deg term make steering worse.)


# ── Temporal gate on the tube reading ────────────────────────────────────────
# A per-frame detector, however good, cannot rule out a reading that is physically
# impossible. The 2026-08-17 run logged the tube at x = 233, 290, 158, 61, 256, 168,
# 14 within about two seconds — the robot creeps at ~0.2 m/s and cannot cross the frame
# in 100ms, so most of those were false whatever the detector said. This keeps the last
# accepted column and rejects anything that jumps further than the robot could have
# moved; after enough consecutive rejections it gives up and re-acquires, so a genuine
# re-acquisition after losing the tube still works.
#
# THESE GATES ARE DERIVED, NOT WRITTEN DOWN. See _gates().
#
# The bug this fixes is not a wrong number, it is a wrong UNIT. Every gate here used to be
# a count of seconds or pixels chosen when the ESP32-CAM delivered a frame every ~710ms.
# The USB camera delivers one every ~33ms, so each of them silently changed meaning by 21x
# the day the camera was swapped, and nothing failed loudly:
#
#   _TRACK_MAX_JUMP_PX = 70   sized for 12-24cm of travel between frames. At 0.57cm it
#                             rejects nothing at all — the backstop against the tube column
#                             teleporting (233 -> 290 -> 158 -> 61) had quietly gone inert.
#   _TRAVERSE_MIN_SIGHTS = 4  over 2.5s. At 1.4fps that is ~every frame in the window and a
#                             strong test; at 30fps it is 4 sightings in 75 frames, a 5% hit
#                             rate — and that latch decides the robot turns onto a row.
#   _TUBE_GRACE_S = 0.4       12 frames. At a 27% miss rate the chance of 12 consecutive
#                             misses is ~1e-6, so the "tube genuinely lost -> stop" fail-safe
#                             could never fire.
#
# So the gates are now expressed in the units the ROBOT cares about — metres of ground and
# frames of evidence — and converted to seconds/pixels at run time from the camera's MEASURED
# interval. A future camera change re-derives them instead of re-breaking them.
#
# RE-ACQUISITION. The jump gate is necessary — it fires on 7% of a real pass — but it needs an
# escape, or after the robot genuinely moves the gate would reject the true new position for
# ever. Two hatches: enough consecutive rejects that AGREE, or an anchor too old to mean
# anything.
#
# THE REJECTS MUST AGREE, and that is the fix. The old rule counted six consecutive rejects and
# then believed WHICHEVER FRAME HAPPENED TO BE SIXTH. Measured over 2086 consecutive frames: of
# 9 relock events, 6 were onto a consistent position (spread 1-22px) and 3 were onto pure
# scatter — spreads of 185px, 79px and 54px. One relock in three was jumping the anchor onto
# noise, which then poisons the gate for every following frame.
#
# So a relock now requires the pending rejects to lie within the jump gate OF EACH OTHER, and it
# anchors on their MEDIAN rather than the last one. Six readings agreeing on a new position is
# real evidence; six scattered readings are evidence of nothing.
#
# (The frame-budget audit predicted trouble here for a different reason — that this hatch and
# the stale-anchor one had swapped which fires first, 4.3s/2-frames at 1.4fps becoming
# 0.23s/39-frames at 26fps. That is true and it is why relock now does the work, but the swap
# on its own was harmless; the missing agreement check was the actual defect.)
_TRACK_RELOCK_N    = 6      # consecutive AGREEING rejects before believing the new position
# How far the robot may travel before the anchor is meaningless regardless. Expressed in metres
# so it survives a speed or frame-rate change; 0.25m is ~1.5s at 0.170 m/s, which is what the
# old flat _TRACK_STALE_S = 1.5 amounted to at this speed.
_TRACK_ANCHOR_MAX_M = 0.25

# Vertical image scale. RE-MEASURED 2026-08-19 FOR THE QHM-999RL webcam: 729.2 px/m, by pushing
# the robot a tape-measured 1.000m and reading the real FlowOdometer (scripts/calib_odometer.py) —
# it reported 0.6690m over 1199 frames with 0 rejected, and went flat for the last 19 seconds,
# which is what proves the push finished. Full derivation in vision/odometry.py.
#
# The old 1090.0 was a Logitech C310 measurement (16mm tube reading 20.9px at the bottom row,
# 13.0px at the top). That camera is gone and this one has a wider lens, so 1090 was the wrong
# camera's constant and made every camera-measured distance read a third short.
#
# Used here to convert "how far has the crossing band moved" into "how far did we drive", so the
# traverse approach gate (_TRAVERSE_APPROACH_FRAC * span_m * _PX_PER_M_DEPTH) was demanding ~1.5x
# more band movement than the geometry actually produces — i.e. it was harder to satisfy than
# intended, which fits traverse never having latched in the field.
_PX_PER_M_DEPTH = 729.2

# HOW FAR THE TUBE COLUMN MAY MOVE, per second of elapsed time rather than per frame.
# 900 px/s puts the gate at ~30px at 30fps and pins it to the ceiling on a slow camera, so
# both cameras get a real test instead of one getting none.
#
# THE FLOOR IS THE INTERESTING PART. Physical motion at 30fps is only ~7.5px (5.7mm of travel
# at 0.76 mm/px), so it is tempting to gate at 10px. Measured against 45 real detections, the
# detector's OWN position noise is p90 7.5px, p99 18.8px, max 22.0px — the measurement is
# NOISIER THAN THE MOTION. Gating below ~25px would therefore reject good frames on noise, and
# no amount of controller tuning recovers a reading that was thrown away. The ceiling is 90px
# because the tube's x_near spanned only 78..229 across an entire run, so a 90px step is
# already most of the operating range.
_TRACK_JUMP_PX_PER_S = 900.0
_TRACK_JUMP_PX_MIN   = 25
_TRACK_JUMP_PX_MAX   = 90
# HOW LONG A DETECTION GAP TO DRIVE THROUGH before stopping.
# The detector achieves 69% on real captures (measured over 80 frames, 2026-08-18) — the 31%
# it misses are frames where the robot's own shadow corrupts one of the four bands, and five
# different discriminators failed to separate those from genuine non-tube frames. But at 30fps
# that still leaves ~20 good readings a second, and the tube does not move in 33ms.
#
# Stopping on the FIRST missed frame is what made the robot halt after ~10cm: it was not
# losing the tube, it was hitting one bad frame in three. So carry the last good reading for
# a short grace period. At 0.170 m/s, 0.4s is 7cm driven on a slightly stale correction —
# far less bad than lurching to a halt three times a second.
#
# This is a tolerance, not a blindfold: past the grace period the robot still stops, which is
# what protects it when the tube genuinely leaves the view.
# Expressed as GROUND DISTANCE plus a cap in FRAMES, whichever runs out first — the two
# things that actually matter, neither of which changes when the camera does.
#
# 0.035m at 0.170 m/s is 0.21s, which at 30fps is ~6 frames. The 6-frame cap agrees, and is
# what bounds it on a faster camera. Six consecutive misses at the measured 27% miss rate has
# probability 0.27^6 = 4e-4, so the grace absorbs shadow gaps while a genuine loss still stops
# the robot within ~3.5cm. The old 0.4s let it drive 6.8cm on a reading that never expired.
_TUBE_GRACE_M          = 0.035
_TUBE_GRACE_MAX_MISSES = 6
# A held reading used to be replayed IDENTICALLY every frame, which is not "carrying a
# measurement through a gap" — it is a 0.4s open-loop turn at whatever differential the last
# good frame asked for. The held correction now decays to zero across the grace window, so the
# robot straightens as its information goes stale instead of committing harder to it.
_tube_hold = {"t": 0.0, "tube": None, "misses": 0}


def _gates(interval=None):
    """Every frame-rate-dependent gate, derived from the camera's MEASURED frame interval.

    Called with bus.interval(); falls back to a conservative 100ms before two frames have
    arrived. _DRIP_SPEED_MPS is read here rather than at module level on purpose — it is
    defined further down the file, and a module-level reference to it would be exactly the
    import-ordering bug that tests/test_console_imports.py exists to catch.
    """
    iv = interval if (interval and interval > 0) else 0.10
    v = max(0.01, _DRIP_SPEED_MPS)
    return {
        "interval": iv,
        # how far the tube column may jump between readings
        "jump_px": max(_TRACK_JUMP_PX_MIN,
                       min(_TRACK_JUMP_PX_MAX, _TRACK_JUMP_PX_PER_S * iv)),
        # how long to carry a lost reading: a distance budget, but never less than one
        # frame's worth or a slow camera would expire the grace before it could ever help
        "grace_s": max(iv * 1.5, _TUBE_GRACE_M / v),
        "grace_misses": _TUBE_GRACE_MAX_MISSES,
        # how far the emitter box may be out of date before it stops setting the creep
        "emit_stale_m": _EMIT_MAX_STALE_M,
        # how long the tracking anchor stays meaningful, as a distance
        "anchor_max_s": _TRACK_ANCHOR_MAX_M / v,
    }


def _gates_str(g):
    return ("frame %.0fms | tube jump <=%.0fpx | grace %.0fms or %d misses (%.1fcm) | "
            "emit stale <=%.0fcm"
            % (g["interval"] * 1000, g["jump_px"], g["grace_s"] * 1000, g["grace_misses"],
               100 * g["grace_s"] * _DRIP_SPEED_MPS, 100 * g["emit_stale_m"]))
# PLAUSIBLE FOR THIS CAMERA. The detector reports what the profile says; how wide the
# tube can look from this camera at this height is the robot's knowledge, not the
# detector's. Measured across every real following frame: 38, 40, 46, 46, 62, 68, 70,
# 70, 78 px. The false positive that sent the alignment loop chasing bare soil on
# 2026-08-17 was 20px. The gap is wide enough to gate on and it costs nothing.
# GATE ON width_fwhm, NOT width. `width` changes meaning depending on whether pair-centring
# succeeded AND it is computed from the WHOLE-FRAME profile, which smears when the tube is
# diagonal — so it collapsed exactly when the robot was off-heading and most needed to steer.
# Measured over 2086 consecutive frames: `width` is bimodal (p10 14, median 44) while
# `width_fwhm` is unimodal with median 14, which agrees with the independent measurement of the
# 16mm tube as a ruler (13-21px across). The old `_TUBE_MIN_W_PX = 30` was therefore rejecting
# 321 of 1010 good detections — 32% — including 4.2-sigma reads of a plainly visible tube.
#
# 5 is a floor against degenerate 1-2px "features", not a real discriminator. It costs 4% recall
# against no gate at all (87% vs 91%) and keeps a sanity check. The actual protection against
# false positives is three-layered and none of it is this number: strength >= 2.5, three-of-four
# band agreement on a fitted line, and _track_tube's temporal jump gate.
#
# STILL A C310 NUMBER, and the only one left (2026-08-19). Everything above — the 13-21px ruler,
# the median of 14 — was measured on the old camera. The QHM-999RL has a WIDER lens: the depth
# scale came out 729 px/m against the C310's 1090, so the same 16mm tube now projects to roughly
# two thirds of its old width, i.e. about 9px rather than 14. A 5px floor still clears that, so
# this is not urgent — but it is 5 against 9 instead of 5 against 14, and the margin has halved.
#
# MEASURE IT before trusting a tube-following run: put the drip tube in frame, save one frame, and
# read `width_fwhm` out of detect_tube. If it comes back near 9 this constant is fine as-is; if it
# comes back at 5-6 the floor is now cutting into real detections and must drop. This cannot be
# derived from the depth scale — lateral and depth scales differ under an oblique view — so it
# needs the tube, which is why it is recorded here rather than guessed at now.
_TUBE_MIN_FWHM_PX = 5
_TUBE_MIN_SIGMA  = 2.5
_track = {"x": None, "rejects": 0, "last_ok": 0.0, "pending": []}
# Which gate is throwing frames away, counted over the log window. THE POINT IS THE RATIO:
# a run that halts constantly looks identical in the log whether the tube is genuinely absent
# or a threshold is miscalibrated, and on 2026-08-18 it was the threshold — for a whole session.
_reject_tally = {}


def _tube_reject(tube):
    """Why this reading is not usable, or None if it is. NAMES THE GATE THAT REJECTED IT.

    Returning a bare boolean is what let a miscalibrated width gate discard 32% of good
    detections through an entire field session: the log could only say "tube lost", and the
    reason had to be reconstructed by comparing numbers printed beside it against a constant
    the reader would have to go and look up. The caller aggregates these strings into a
    histogram, so "94% of rejections were `width`" shows up in one run instead of three.
    """
    if not tube["found"]:
        return tube.get("reject") or "not-found"
    if (tube.get("width_fwhm") or 0) < _TUBE_MIN_FWHM_PX:
        return "fwhm-%s<%d" % (tube.get("width_fwhm"), _TUBE_MIN_FWHM_PX)
    if tube["strength"] < _TUBE_MIN_SIGMA:
        return "sigma-%.1f<%.1f" % (tube["strength"], _TUBE_MIN_SIGMA)
    return None


def _tube_plausible(tube):
    """Is this reading the right SHAPE to be our tube, seen from our camera?"""
    return _tube_reject(tube) is None


def _track_reset():
    _track.update(x=None, rejects=0, last_ok=0.0, pending=[])


def _tube_with_grace(tube, now, gates):
    """Carry the last good reading through a brief detection gap, with DECAY.

    Returns (tube, holding) — `holding` is True when this is a remembered reading rather
    than a fresh one, so the caller can log it and decide how much to trust it.

    Two bounds, whichever runs out first: a ground-distance budget and a count of
    consecutive missed frames. The frame count is what protects a fast camera (where the
    distance budget is many frames) and the distance is what protects a slow one.

    The correction DECAYS linearly to zero across the window. Replaying the last command
    unchanged, as this used to, means the robot keeps turning at full commanded rate on
    information it no longer has — the longer it is blind the harder it commits. Decaying
    means it straightens as the reading ages, so the worst case is driving straight rather
    than driving in a circle.
    """
    if tube["found"]:
        _tube_hold.update(t=now, tube=tube, misses=0)
        return tube, False
    held = _tube_hold["tube"]
    if held is None:
        return tube, False                    # never seen the tube: do not drive on nothing
    age = now - _tube_hold["t"]
    _tube_hold["misses"] += 1
    if age > gates["grace_s"] or _tube_hold["misses"] > gates["grace_misses"]:
        return tube, False
    k = max(0.0, 1.0 - age / max(1e-6, gates["grace_s"]))
    out = dict(held)
    out["correction"] = round((held.get("correction") or 0.0) * k, 3)
    if held.get("far_correction") is not None:
        out["far_correction"] = round(held["far_correction"] * k, 3)
    out["held_for"] = round(age, 3)
    out["held_misses"] = _tube_hold["misses"]
    out["held_decay"] = round(k, 2)
    return out, True


def _tube_grace_reset():
    _tube_hold.update(t=0.0, tube=None, misses=0)


def _track_tube(tube, w, now, max_jump_px, anchor_max_s=1.5, hinted=False):
    """Accept, reject or re-acquire this frame's tube reading.

    `max_jump_px` comes from _gates() rather than a constant, because how far the tube can
    plausibly move depends entirely on how long ago the last reading was taken.

    `hinted` only affects the LOG. A reject means two opposite things: cold, the detector had
    nothing to go on and losing the tube among stronger features is expected; hinted, it was
    told within 45px of where the tube actually was and STILL could not find it, which is a real
    detector failure. Reading them off one undifferentiated histogram, as we did all day, makes
    a run of expected cold misses look identical to the detector being broken.
    """
    why = _tube_reject(tube)
    if why is not None:
        _track["rejects"] = 0            # nothing to disagree with; do not count it
        _reject_tally[why] = _reject_tally.get(why, 0) + 1
        if hinted:
            _reject_tally["(of those, hinted)"] = \
                _reject_tally.get("(of those, hinted)", 0) + 1
        out = dict(tube)
        out["reject"] = why
        if tube["found"]:                # found, but not tube-shaped: say so
            out.update(found=False, correction=0.0, far_correction=0.0, implausible=True)
        return out
    x = tube["tube_x"]
    prev = _track["x"]
    stale = (now - _track["last_ok"]) > anchor_max_s
    if prev is None or stale or abs(x - prev) <= max_jump_px:
        _track.update(x=x, rejects=0, last_ok=now, pending=[])
        return tube

    # Rejected. Remember WHERE it wanted to go, because a run of rejects that agree with each
    # other is a real re-acquisition and a run that scatters is noise — and the old code could
    # not tell the difference.
    pend = _track["pending"]
    pend.append(x)
    if len(pend) > _TRACK_RELOCK_N:
        del pend[0]
    _track["rejects"] += 1
    if len(pend) >= _TRACK_RELOCK_N and (max(pend) - min(pend)) <= max_jump_px:
        anchor = sorted(pend)[len(pend) // 2]        # median, not the newest
        _track.update(x=anchor, rejects=0, last_ok=now, pending=[])
        out = dict(tube)
        out["relocked_to"] = anchor
        return out

    out = dict(tube)
    out.update(found=False, correction=0.0, far_correction=0.0, rejected_x=x,
               reject_run=_track["rejects"],
               pending_spread=round(max(pend) - min(pend), 1) if len(pend) > 1 else 0.0)
    return out


def _steer(tube):
    """Differential PWM from a LOOKAHEAD-weighted error.

    The robot used to steer on the tube's position averaged over the whole frame, and it
    would not correct until the tube had reached the wheels — then it corrected hard,
    overshot, and zig-zagged. That is a structural fault, not a gain that needed tuning:
    with the robot still over the tube at the wheels but pointing off, the displacement is
    ALL at the top of the frame, so the average halves it and the half it keeps describes
    where the robot IS rather than where it is GOING.

    So the error is a blend of two points the detector now reports separately: the tube at
    the robot (cross-track) and the tube at the top of the frame (lookahead). Weighted
    toward the lookahead, the robot starts correcting while the error is still small, which
    is what removes the oscillation; the cross-track term is what stops it settling
    parallel to the row but offset from it. This is the standard geometry for row guidance
    — Pure Pursuit / Stanley — and lookahead is the parameter that matters.

    Both terms use `correction` units and the SAME sign convention ("+ = tube is right ->
    steer right"), deliberately: an earlier version fed the tube's tilt angle in as a
    derivative term and made steering worse, because the angle's sign was never verified
    against the robot. far minus near IS that tilt, expressed in units whose sign is
    already pinned by the detector's contract.

    NOTE the lookahead is only as good as the camera geometry, which is unmeasured — the
    weights below are a starting point, not a calibration. Too little lookahead hunts
    (where we started); too much cuts corners and ignores real offset.
    """
    near = tube.get("correction") or 0.0
    far = tube.get("far_correction")
    if far is None:                       # detector without a lookahead point
        far = near
    err = _STEER_W_FAR * far + (1.0 - _STEER_W_FAR) * near
    if abs(err) < _STEER_DEADBAND:
        err = 0.0
    d = _STEER_GAIN * err
    if d and abs(d) < _STEER_MIN_DIFF:                 # floor, so small errors DO move it
        d = _STEER_MIN_DIFF if d > 0 else -_STEER_MIN_DIFF
    return int(max(-60, min(60, d)))                   # cap: never reverse a wheel
# Tube-following creeps at _BASE_PWM, well below the PWM the drive was calibrated at.
# Scaling the calibrated cruise speed by the duty ratio (0.628 * 77/180 = 0.269 m/s)
# OVER-reports badly: a run told to cover 5 m declared itself finished after about 3 m
# of real ground. Speed is not linear in PWM — near the deadband most of the duty goes
# into overcoming stiction, not into motion.
#
# Two runs have now calibrated it by observation, and they disagreed because the robot
# was stuttering — every tube dropout costs acceleration time, so the effective speed
# depended on how badly the detector was misbehaving that run:
#     assumed 0.269 -> commanded 5m, covered ~3m  => ~0.161 m/s
#     assumed 0.161 -> commanded 5m, covered ~7m  => ~0.225 m/s   (steady following)
# The second is from the run where the tube was actually being tracked, so it is the
# better number. It is still an observation, not a measurement. MEASURE IT:
#     ssh unoq 'python3 ~/motor-control/scripts/field_test.py fwd 77 10 0.83'
#     creep = (metres the robot actually moved) / 10   -> put it in CAL["creep"]
_DRIP_SPEED_MPS = CAL.get("creep") or (0.225 * _BASE_PWM / float(_CAL_PWM))
if CAL.get("creep") and CAL.get("creep_pwm") != _BASE_PWM:
    print("WARNING: creep speed %.3f m/s was measured at PWM %s but _BASE_PWM is %d — "
          "re-run `field_test.py fwd %d 10 0.83` and update CAL[\"creep\"], or every "
          "distance this run reports will be wrong."
          % (CAL["creep"], CAL.get("creep_pwm"), _BASE_PWM, _BASE_PWM), flush=True)

# THE MOISTURE PROBE IS NOT FITTED, so it must not vote on emitter detection.
# uno-q-wiring.md: "The seeder uses D10/A3/D11/D13; the probe uses A4/A5/D2" — the two are
# mutually exclusive attachments, and A4/A5 now carry the gyro. So during a seeding run A0/A1
# are FLOATING, and they read 1855/2099 out of 16383, which is below the 9000 "wet" threshold.
# detect_emitter_ml adds +0.4 confidence when wet, so every frame got that bonus for free:
#   conf = 0.6 x ml_value + 0.4
# which means an ml_value of only 0.25 clears the 0.55 gate. Reading back from the three
# false positives logged on 2026-08-18 (conf 0.92/0.74/0.86 on frames showing PLAIN TUBE):
#   ml was 0.87 / 0.57 / 0.77  ->  without the bonus: 0.52 / 0.34 / 0.46, all REJECTED.
# So a disconnected sensor was manufacturing the confidence that let plain tube pass.
MOISTURE_PRESENT = False


def _moisture_min():
    if not MOISTURE_PRESENT:
        return None                 # None -> detect_emitter_ml leaves `wet` False
    try:
        m = json.loads(_decode(Bridge.call("getMoisture")))
        return min(m.get("a0", 16383), m.get("a1", 16383))
    except Exception:
        return None

_mdns_cache = {}          # name -> (expires_at, ip)
_MDNS_TTL = 60.0          # short: the cam's IP changes with the network it joins


def _resolve_mdns(name):
    """Resolve a *.local name to an IP, asking the host helper to do it.

    This container's DNS is Docker's internal resolver, which has no mDNS, and
    multicast doesn't cross the bridge to wlan0 — so `farmcam.local` is
    unresolvable in here. The host runs avahi and can resolve it, so we ask it.
    Returns the name unchanged if that fails, leaving the error to the caller.
    """
    now = time.time()
    hit = _mdns_cache.get(name)
    if hit and hit[0] > now:
        return hit[1]
    url = "http://%s:%d/resolve?name=%s" % (_host_gateway(), HELPER_PORT, name)
    try:
        with urllib.request.urlopen(url, timeout=3) as r:
            ip = json.loads(r.read()).get("ip")
        if ip:
            _mdns_cache[name] = (now + _MDNS_TTL, ip)
            log("resolved %s -> %s (via host)" % (name, ip))
            return ip
        log("resolve %s: helper returned no ip" % name)
    except Exception as e:                    # noqa: BLE001
        log("resolve %s failed: %s" % (name, e))
    # FALL BACK TO THE LAST KNOWN IP, even expired. The helper timed out once on
    # 2026-08-18 and the loop got the bare name back, which cannot resolve inside this
    # container — so the camera failed to open at all and stayed down until someone
    # pressed Connect. A stale IP is nearly always right (the cam holds its DHCP lease)
    # and is strictly better than a name we know will fail.
    if hit:
        log("  using last known %s -> %s (resolve failed)" % (name, hit[1]))
        return hit[1]
    return name


def _host(hostport):
    """Swap a bare *.local host for its IP, preserving any :port suffix."""
    host, _, port = hostport.partition(":")
    if host.endswith(".local"):
        host = _resolve_mdns(host)
    return host + (":" + port if port else "")


def _stream_url(base):
    """Accept 'ip', 'host.local', 'http://…', a full URL, or a USB camera -> source spec.

    A USB camera is passed through UNCHANGED for FrameBus to route. Without this, '2' went
    through the mDNS/host path and came out as 'http://2:81/stream'.
    """
    b = str(base).strip()
    if not b:
        return ""
    if b.lower() in ("usb", "auto", "webcam") or b.startswith("/dev/video") or b.isdigit():
        return b                              # USB camera: FrameBus._open handles it
    if b.startswith("http"):
        rest = b.split("://", 1)[1]
        hostport, slash, tail = rest.partition("/")
        b = "http://" + _host(hostport) + slash + tail
        return b if "/stream" in b else b.rstrip("/") + ":81/stream"
    hostport = _host(b)                       # bare 'ip' / 'host.local' / either with :port
    if ":" not in hostport:
        hostport += ":81"                     # the ESP32-CAM's stream port
    return "http://%s/stream" % hostport

def _cam_loop(url):
    """Guarded entry point. WHATEVER happens inside, release the camera and stop the wheels.

    This wrapper exists because of a specific, expensive failure on 2026-08-18: an
    UnboundLocalError on the first frame killed the loop thread, and because `bus.stop()`
    was the last STATEMENT of the loop rather than a guaranteed one, the FrameBus reader
    thread survived and kept streaming the V4L2 device. A V4L2 camera streams to one
    consumer, so every subsequent Connect opened the same device, got no frames, and leaked
    another orphan reader — the camera stayed dead until the container was restarted, and
    the log only ever showed "camera open failed".

    Two guarantees, and they are worth more than the typo that motivated them:
      * THE CAMERA IS ALWAYS RELEASED, so a crash costs one loop, not the device.
      * THE MOTORS ARE ALWAYS STOPPED. The old code left the last setMotors latched when
        the loop exited for ANY reason — a crash, or the operator simply changing camera
        mid-run. Same fail-safe as "no frame = no eyes -> stop", one level further out.

    `held` is a cell rather than a return value because the bus must be reachable from the
    finally even when the body raised before it could return anything.
    """
    held = {}
    try:
        _cam_loop_run(url, held)
    except Exception:                                          # noqa: BLE001
        # PRINT THE TRACEBACK. A bare thread exception goes to stderr and is easy to miss
        # in the container log; routing it through log() puts it in the operator's log too,
        # beside the frames and decisions that led up to it.
        log("camera loop CRASHED — releasing the camera and stopping the motors:\n%s"
            % traceback.format_exc())
    finally:
        # STOP THE WORKER BEFORE THE BUS. It reads bus.latest() in a loop, and tearing the bus
        # out from under it would just log an exception per iteration until it noticed.
        worker = held.get("emit")
        if worker is not None:
            try:
                worker.stop()
            except Exception:                                  # noqa: BLE001
                log("camera loop exit: emitter worker stop raised:\n%s"
                    % traceback.format_exc())
        bus = held.get("bus")
        if bus is not None:
            try:
                bus.stop()
            except Exception:                                  # noqa: BLE001
                log("camera loop exit: bus.stop() raised:\n%s" % traceback.format_exc())
        try:
            _drive_stop("cam-loop-exit")
        except Exception:                                      # noqa: BLE001
            log("camera loop exit: could not stop the motors:\n%s" % traceback.format_exc())
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
