saravmajestic/yaerbot/tests/test_golden_frames.py

"""THE TEST THAT SHOULD HAVE EXISTED FIRST: can it find the tube in a real frame?

On 2026-08-18 this suite had 149 passing tests while the robot could not follow a tube at all.
Every one of them tested a MECHANISM — grace decay, jump gates, reject tallies, noise floors —
and every one would still pass against a detector that finds nothing, because not one of them
asked the only question that matters:

    given a real frame with an obvious tube, is the tube found, roughly where it is?

So these are real field frames with hand-labelled tube positions. They are the product
requirement, not a property of the implementation, and they are allowed to fail — a red test
here means the robot cannot follow a tube, which is worth knowing from a laptop rather than
from a field session.

LABELS are the tube's centre column at the BOTTOM of frame, which is what x_near reports. They
were read off a 40px gridline overlay by eye, so they are accurate to roughly +/-20px; the
tolerance below is set wider than that deliberately. The point is to separate "on the tube" from
"locked onto a different feature", and every real failure has been 70-160px out, not 30.
"""
import os
import sys

import cv2
import pytest

sys.path.insert(0, os.path.join(os.path.dirname(os.path.dirname(os.path.abspath(__file__))),
                                "console", "python"))

import vision.vision as V                                    # noqa: E402

# THE FRAMES LIVE IN THIS REPO, deliberately. They were first read from the ai-labs captures
# directory next door, which is gitignored as bulk capture data — so on any machine but the one
# that shot them these tests called pytest.skip and reported GREEN while testing nothing. A test
# whose fixtures are not in the repo is not a regression test; it is a note.
#
# Seven hand-labelled frames are 400KB, which is a fixture, not a dataset. The thousands of raw
# captures stay next door where they belong.
FRAMES = os.path.join(os.path.dirname(os.path.abspath(__file__)), "frames", "golden")

# filename -> tube centre column at the bottom of frame, and a note on why it is here
GOLDEN = {
    "lost_121524.jpg":            (168, "12:16 run: tube dead centre, 4-band froze the robot 36s"),
    "cap_20260818_110504_150.jpg": (175, "11:05: uniform light, strong tube, one band on straw"),
    "cap_20260818_110502_124.jpg": (178, "11:05: same stretch a frame earlier"),
    "emit1_lat1_111611.jpg":      (178, "the plant stop — all four bands agreed here"),
    "cap_20260818_105926_367.jpg": (180, "midday: sun/shade boundary stronger than the tube"),
    "live_1245.png":              (150, "12:45 live grab: bottom band landed 70px off the tube"),
    "cap_20260818_104428_437.jpg": (55,  "10:44: 3-band took an overexposed edge, steered off row"),
    # 2026-08-19, operator-captured: the robot STOPPED here with the tube plainly visible.
    # Diagnosed in full — bands 0 and 3 land on the tube (181, 201) while bands 1 and 2 are dragged
    # to 147 and 138 by a dark soil region beside it. The wrong bands are STRONGER than the tube
    # (4.46 sigma against 3.46), so no confidence or width gate separates them, and the line fit
    # needs three of four. Constraining pair-centring to the seed window does not rescue it: at the
    # default +/-45 the bad centre is still inside the window, and at +/-35 or tighter the bands find
    # nothing at all. Label is approximate — the two good bands bracket the tube at 181-201.
    "cap_20260819_094944_877.jpg": (190, "operator frame: robot stopped, tube visible, soil beside it "
                                         "outshines the tube in two of four bands"),
}

# 50px, set by LABEL PRECISION rather than by what makes the suite green: the labels were read
# off a gridline overlay by eye and are good to about +/-20px, so a tighter tolerance would be
# measuring my eyesight. Every real failure this set documents was 70-238px out.
TOL_PX = 50


def _load(name):
    # FAIL, do not skip. These frames are committed alongside this file, so a missing or
    # undecodable one means the fixtures were damaged — and skipping would hide that behind a
    # green run, which is the exact failure mode that made this suite worthless before.
    p = os.path.join(FRAMES, name)
    assert os.path.exists(p), "golden frame missing from the repo: %s" % p
    im = cv2.imread(p)
    assert im is not None, "could not decode golden frame %s" % p
    return im if im.ndim == 3 else cv2.cvtColor(im, cv2.COLOR_GRAY2BGR)


# KNOWN FAILING, documented rather than hidden: tube at the very frame edge with a blown-out
# highlight beside it. Even hinted, the seeded search cannot recover it — the competing feature is
# stronger than the tube in every band. It stays in the set as an xfail so the limit is visible and
# so it flips to a pass by itself if the detector ever improves.
KNOWN_HARD = {
    # tube at the very frame edge with a blown-out highlight beside it; the competing feature is
    # stronger than the tube in every band, so even a hint cannot recover it
    "cap_20260818_104428_437.jpg",
    # harsh midday: the tube reads 0.3-0.5 sigma at its centre while the sun/shade boundary reads
    # 2.8. There is no signal to find, and REJECTING is the correct answer — the detector does
    # reject it now. Kept as an xfail so the lighting limit is visible rather than forgotten.
    "cap_20260818_105926_367.jpg",
    # see the note in GOLDEN: two bands are captured by a stronger dark soil region beside the tube.
    # Kept as a visible xfail rather than left out, so it flips to a pass by itself if the band search
    # ever learns to prefer continuity over raw strength.
    "cap_20260819_094944_877.jpg",
}


@pytest.mark.parametrize("name", sorted(GOLDEN))
def test_tube_is_found_near_the_truth_when_tracking(name, request):
    if name in KNOWN_HARD:
        request.node.add_marker(pytest.mark.xfail(
            reason="tube at frame edge beside a blown highlight — unsolved", strict=False))
    """WITH a hint, i.e. what the robot has in steady following once it has the tube.

    This is the case that must work: the tracker knows roughly where the tube was, so each band
    searches near it instead of taking the strongest peak anywhere in the frame.
    """
    truth, why = GOLDEN[name]
    t = V.detect_tube(_load(name), hint_x=truth)
    assert t["found"], "%s: no tube found at all (%s) — reject=%s" % (name, why, t.get("reject"))
    err = abs(t["x_near"] - truth)
    assert err <= TOL_PX, "%s: found x=%.0f, truth ~%d, off by %.0fpx (%s)" % (
        name, t["x_near"], truth, err, why)


def test_most_frames_are_found_with_no_hint_at_all():
    """WITHOUT a hint — first frame of a run, or after a genuine loss. Weaker requirement, since
    with nothing to go on the detector can legitimately be fooled by a stronger competing
    feature; that is what the 10:44 frame is in this set to document. But it must not be hopeless.
    """
    ok, detail = 0, []
    for name, (truth, _why) in sorted(GOLDEN.items()):
        t = V.detect_tube(_load(name))
        good = t["found"] and abs(t["x_near"] - truth) <= TOL_PX
        ok += 1 if good else 0
        detail.append("%s:%s" % (name.split("_")[0],
                                 "ok" if good else ("x=%.0f" % t["x_near"] if t["found"]
                                                    else t.get("reject", "rej"))))
    assert ok >= len(GOLDEN) // 2, \
        "cold-start found %d/%d within %dpx — %s" % (ok, len(GOLDEN), TOL_PX, ", ".join(detail))


def test_the_hint_actually_helps():
    """If seeding made no difference, it is not earning its complexity. Measured across this set,
    the hinted pass should find strictly more frames correctly than the cold one."""
    hinted = cold = 0
    for name, (truth, _why) in GOLDEN.items():
        im = _load(name)
        h = V.detect_tube(im, hint_x=truth)
        c = V.detect_tube(im)
        hinted += 1 if (h["found"] and abs(h["x_near"] - truth) <= TOL_PX) else 0
        cold += 1 if (c["found"] and abs(c["x_near"] - truth) <= TOL_PX) else 0
    assert hinted >= cold, "hinting made it WORSE: %d vs %d of %d" % (hinted, cold, len(GOLDEN))


def test_a_stale_hint_does_not_drag_the_answer_off_the_tube():
    """The hint is the LAST position, not the current one, so it is always a little wrong. It
    must pull the search toward the tube without pinning the answer to itself — otherwise the
    detector would report the hint back and the robot would never correct."""
    for name, (truth, _why) in sorted(GOLDEN.items()):
        if name in KNOWN_HARD:
            continue
        im = _load(name)
        for offset in (-30, +30):
            t = V.detect_tube(im, hint_x=truth + offset)
            if not t["found"]:
                continue
            assert abs(t["x_near"] - truth) <= TOL_PX + 15, \
                "%s: hint %+dpx off dragged the answer to x=%.0f (truth ~%d)" % (
                    name, offset, t["x_near"], truth)
