saravmajestic/yaerbot/(commit log)

2026-08-09 feat(farmos): Act 2 + Act 4 — boustrophedon path, timed-DR executor, SVG report
    Hardware-free software brain for plain-land seeding:
    - config.py SeedPlan (metres; from_feet helper)
    - path.py boustrophedon planner -> serpentine seed waypoints
    - robot_io.py RobotIO interface + SimRobot (dead-reckoning, models slip) + BridgeRobot (real UNO Q, untested)
    - executor.py timed dead-reckoning executor -> RunLog (planned vs executed + stats)
    - report.py RunLog -> self-contained SVG farm map (Act 4)
    - tests/ 12 unit tests (path/executor/report) — all pass
    - examples/plain_field_demo.py end-to-end config->path->sim->log->report
    C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
    [config.py, executor.py, path.py, report.py, robot_io.py, test_executor.py, test_path.py]
2026-08-09 feat(planner): real dual-calendar data — Tamil panchangam + biodynamic
    Act 1 data layer (all real, no fabrication):
    - panchangam_cache.json: moon nakshatra at sunrise, Aug 10-Sep 10 2026, pulled from drikpanchang
    - nakshatra_nokku.json: traditional 27-nakshatra -> Keezh/Sama/Mel classification (sourced)
    - biodynamic_cache.json: root/leaf/flower/fruit + avoid(kari naal) + moon phases, 2026, extracted from the Biodynamic Association of India 2026 Tamil sowing calendar (pdftotext, verbatim)
    - crops.json: crop -> required nokku + biodynamic type + spacing geometry
    Dual-system result for groundnut: only 2026-09-03 (Krittika/Keezh + biodynamic root, not a kari-naal avoid day) is favourable in B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
2026-08-09 feat(planner): reconcile panchangam + biodynamic -> dual-validated recommendation
    almanac.py reconciles the two real calendars per date (nakshatra->Nokku, biodynamic
    root/leaf/fruit/flower, kari-naal avoid). planner.recommend() returns the earliest date
    favourable in BOTH systems and not an avoid day, with rationale, and to_seed_plan() hands
    off to Act 2. Rule-based/deterministic — the LLM layer will drive the same tools for the
    conversational recommendation.
    Groundnut -> 2026-09-03 (Krittika/Keezh + biodynamic root, in season). 6 tests pass;
    examples/full_demo.py runs Act 1->2->4 end to end.
    Claude-Session: https://claude.ai/code/s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
    [test_planner.py]
2026-08-09 feat(planner): survey (all data) + LLM presentation layer
    - planner.survey(): full picture for the LLM — both-systems recommendation +
    panchangam-only / biodynamic-only alternatives + kari-naal avoid days
    - tools.py: survey/get_crop_profile/check_day as Ollama tool schemas + dispatch
    - llm.py: OllamaClient (stdlib), StubLLMClient, converse() tool-loop, and present()
    (data-in -> prose-out — the reliable path for small models)
    - Finding: agentic tool-calling at <=2B is unreliable (Qwen invented args + hallucinated);
    data-in presentation is grounded. Gemma 2B presents alternatives more faithfully than
    Qwen 1.5B. Reconciliation stays authoritative; the LLM only presents.
    - 8 planner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
    [test_planner.py]
2026-08-09 feat(planner): market prices (MOCK) + price context in LLM presentation
    - market.py: PriceSource with MockPriceSource (loudly flagged) + get_current_price /
    get_price_history / price_summary (current, 3yr min/max/avg, YoY, recent trend).
    Real path (AgmarknetPriceSource via data.gov.in + cache-fallback) stubbed in comments.
    - data/prices_mock.json: 44 months (2023-01..2026-08) modal ₹/quintal for groundnut/corn/
    sesame, generated by scripts/gen_mock_prices.py (deterministic, seed=42). MOCK, to be
    replaced by real Agmarknet data.
    - llm.present() now takes optional price/weather context; planner_chat_demo shows it.
    - 9 planner tests pass; gemma2:2b presents recommendation + alternativ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
    [gen_mock_prices.py, test_planner.py]
2026-08-09 feat(planner): real weather (Open-Meteo, no key) + cache-fallback
    - weather.py: live Open-Meteo daily forecast for the farm (Salem, TN), certifi SSL,
    cache last-good -> fall back on failure; weather_summary() gives near-term outlook
    (avg tmax/tmin, rain, rainy days) and flags when the sowing date is beyond the ~16-day
    horizon (climatological normals = follow-up). geocode() for arbitrary place names.
    - Wired weather into llm.present() + the chat demo alongside price + calendars.
    - weather_cache.json is a runtime fallback (gitignored). 10 planner tests pass.
    Claude-Session: https://claude.ai/code/session_01F862wSg5B7HBK9Z6quVkKv
    [test_planner.py]
2026-08-09 feat(webchat): Sowing Advisor chat tab (prototype) + corn/sesame crops
    - webchat/server.py + index.html: a standalone chat app wrapping the Act 1 planner —
    farmer asks a crop, backend runs survey+recommend+price+weather and Gemma presents the
    recommendation + alternatives + avoid days; dark console theme, model selector, quick
    crop chips. Designed to drop into the operator console as a 'Plan' tab. LLM-down falls
    back to a deterministic summary.
    - crops.json: add corn + sesame as full planner crops (Mel Nokku / biodynamic fruit).
    - demo-plan: chat tab 🟡 (prototype), decisions table synced (Gemma 2B, data-in present,
    prices mock / weather real).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
2026-08-09 perf(planner): compact prompt + capped output for on-device LLM
    Full-survey-JSON prompts timed out (>3 min) on the UNO Q CPU (~1.9 tok/s Gemma, 2.7
    Qwen). present() now sends a COMPACT summary + caps output (num_predict) + asks for
    2-3 sentences (the UI card shows every date). OllamaClient.chat takes options. On-device
    chat e2e verified: 2026-09-03 + real weather + coherent short answer (~say 1-2 min total).
    Finding recorded in demo-plan: use instant card + pre-warm + short/streamed prose.
    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
2026-08-09 perf(planner): lean prompt halves on-device LLM latency
    On the UNO Q (A53) prompt-eval dominates: a 299-tok prompt took ~90s just to read.
    Shortened PRESENT_SYSTEM + _compact to ~144 tok -> WALL time roughly halved
    (qwen2.5:1.5b 112s->47s, gemma2:2b 129s->87s), quality still good. Flash-attn/q8-KV/
    num_ctx/threads gave ~no gain (CPU-bound). scripts/bench_llm.py added (speed+answer).
    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
    [bench_llm.py]
2026-08-09 feat(webchat): streaming + card-first + no-agreement grounding + dynamic labels
    - server split: /api/plan returns the deterministic card data instantly (~2s, no LLM);
    /api/narrate streams the LLM prose token-by-token (Ollama stream:true relay).
    - UI renders the card first, then streams the prose with a typing cursor.
    - Fix: when no date satisfies BOTH calendars (e.g. corn), the card shows a clear
    'no single date agrees' state and the LLM says so (grounding: recommended_date=null
    handled in PRESENT_SYSTEM) instead of hallucinating a recommendation.
    - Fix: alternative labels are now dynamic per crop (mel/fruit for corn, not hardcoded keezh/root).
    - llm: present_messages() shared by block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
2026-08-09 feat(console): operator console in yaerbot + Plan tab (Act 1)
    - console/: the App Lab operator console (assets + python/main.py + app.yaml + sketch.yaml)
    brought into the contest repo, scrubbed.
    - Plan tab: new tab (index.html/app.js/style.css, pl- namespaced) — card-first + streamed
    prose, dynamic per-crop labels, no-agreement state; calls the planner service at :8765.
    - webchat: CORS (incl. OPTIONS preflight + the streaming /api/narrate response) so the
    console origin (:7000) can call the planner (:8765).
    - CLAUDE.md: how the 3 on-board pieces fit — Ollama service -> planner service -> console,
    with start/deploy steps and the reboot-autostart TODO.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
    [main.py]
2026-08-11 feat(drive): calibrated stop-and-go drive + end-to-end diagnostics
    One seeding row now runs on hardware: three even 40cm hops and a real 90 deg
    pivot. The same run days earlier "rotated randomly within a 30cm square".
    Drive model (farmos/robot_io.py):
    - forward uses a DEAD TIME (startup_s + d/speed). A blind 40cm hop was being
    issued as a sub-dead-time burst that barely translated.
    - turns use a COAST (negative turn_startup_s, opposite sign to forward) and a
    separate, lower turn_pwm: coast is ~75 deg at PWM 180 vs ~38 deg at PWM 120,
    so a 90 deg turn at full duty is mostly coast. Sleeps clamped at 0 so a turn
    smaller than the coast angle can't request a negative sleep.
    - optional de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
    [field_test.py, main.py, robot_io.py, test_batt_comp.py, test_diag.py]
2026-08-11 feat(seed): plain-land plot seeding in the Seed tab (Act 2 + Act 4 in the UI)
    Wires the existing planner/executor/report into the console. Previously they were
    only reachable from scripts/field_test.py on the CLI, and the Seed tab was a timed
    single-row mode measured in SECONDS.
    Flow: pick land type -> walk the boundary marking 4 corners -> enter row/seed
    spacing in cm -> see the serpentine plan drawn to scale with spot/seed counts and
    an estimated run time -> Start (dry run by default) -> live progress -> field report.
    - corner marks are a MOCK and the code says so: with no GPS or encoders they carry
    no position information, so the geometry driven comes from the entered
    width/length.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
2026-08-11 refactor(seed): drop the legacy timed seeding mode
    It expressed spacing as a DURATION, which predates the calibrated drive model and
    can't hold real spacing on any surface. Plot seeding replaces it end to end, so
    keeping it around was just two ways to do the same thing — one of them wrong.
    Removed: the seconds/percent sliders and their run controls (UI), _seed/_seed_cfg/
    _seed_thread, _drive_gap, _seed_loop, _apply_seed_cfg, on_seed_start/pause/stop and
    their message registrations, the "seed" block in get_stats, and renderSeed.
    Kept "Plant once (test)", now refused while a plot run is active rather than
    gated on the old state machine.
    Also restored the shared `bind()` range-label helper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
    [main.py]
2026-08-11 feat(seed): drip-irrigated mode — follow the lateral, plant at each emitter
    Land selector now switches between two flows that take different inputs. Drip
    shares the 4-corner marking, then asks only for approximate emitter spacing and
    seed placement.
    - emitter spacing is explicitly an ESTIMATE: seeds land where the camera sees an
    emitter, so the figure is used only to size the count and to reject a second
    detection of the same emitter.
    - that rejection is now DISTANCE-based, not the old time cooldown. A time cooldown
    is speed-dependent: it double-plants when slow and skips emitters when fast.
    Distance is integrated from the calibrated cruise speed scaled by the follow
    duty (_BASE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
    [main.py]
2026-08-11 refactor(seed): unify the run for both land types; 4-seed cross per emitter
    Two review points, both structural.
    1) ONE run flow. The robot does the same job either way -- drive, stop, plant,
    log, report -- only the PLANT TRIGGER differs (a planned grid position vs an
    emitter the model saw). So state and controls are now shared (_run +
    run_start/run_pause/run_stop + a single "run" message); _plot keeps geometry,
    _drip keeps emitter config. One status line, one dry-run toggle, one Start for
    both; only the config cards differ.
    - drip now produces the Act 4 report too: emitter positions are logged as they
    are planted and rendered through the same render_svg. planned=[] be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
2026-08-11 fix(console): tall panels were unscrollable — their tops were unreachable
    .panel used a FIXED height:100% together with justify-content:center. When a
    panel's content is taller than the viewport that overflows in BOTH directions,
    and the part above the top can't be scrolled to at all — the Seed tab's Land
    selector (and so the drip option) was simply unreachable.
    min-height:100% instead: tall panels grow so .main scrolls them normally, while
    short ones (Drive, Soil, Cam) still centre exactly as before. #panel-plan keeps
    an explicit height:100% because its chat column must fill the viewport rather
    than grow.
    Pre-existing bug that the longer Seed panel exposed; it also affects the Diag
    ta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
2026-08-14 feat(seeder): 4-seed cross, full actuator loop, S3003 calibration mode
    - robot_io: plant_cross(angles, dwell) on BridgeRobot and SimRobot. One stop, N
    arm positions, 2 seeds each — the arm carries 2 outlets 180 deg apart and a
    single solenoid fires both, so (0, 90) lays a true 4-seed cross: 0/180 then
    90/270. Enforces index -> dwell -> drop ordering (a drop must never precede
    its index) and always parks the arm flat for driving.
    - field_test `cycle`: the whole chain n times — hop, 4-seed cross, body turn.
    Not a row on purpose: each pass ends with a turn, so n=4 x 90 deg walks a
    square back to the start and the accumulated error is one visible gap rather
    than three tape meas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
    [field_test.py, main.py, robot_io.py, test_console_imports.py, test_plant_cross.py]
2026-08-15 feat(console): scan mode, multi-row seeding, and make failures visible
    Camera tab is for data collection, Seed tab is for seeding — so the camera tab's
    Follow button no longer plants. New `scan` run mode: follow the tube, capture
    frames, seeder never touched. Kept as its own mode rather than a flag on `drip`
    because a data-collection run must not be one wrong click from firing a solenoid;
    verified mechanically that no seeder RPC is reachable from the scan code path.
    It also does NOT stop at emitters — standing still just fills the dataset with
    near-duplicate frames.
    Three fixes for things that made a working robot look broken during a field
    session (all cost real time on 2026-08-15):
    -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
    [field_test.py, main.py, path.py, test_path.py]
2026-08-16 fix(camera): stale stream livelocked reconnects; declare object_detection brick
    Camera reconnect was impossible once the MJPEG stream died. A dead stream keeps its
    socket open, so read() returns False forever and the loop thread stays ALIVE while
    delivering nothing — and on_set_camera refused to start a replacement precisely
    because a thread was alive:
    if url == _cam["url"] and _cam_thread.is_alive(): return
    Seven Connect clicks in a row did nothing, silently (2026-08-15 log). The guard
    against duplicate loops had become the thing preventing recovery.
    - "streaming" now requires a RECENT FRAME, not just a live thread: _cam["last_frame"]
    is stamped on every successful read, and a lo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
    [main.py]
2026-08-16 feat(repo): port firmware, vision and hardware docs into the submission repo
    The contest requires video demo + SOURCE CODE + project report, and judges score
    Technical Documentation (20/100) explicitly on "BOM, circuit schematics, code
    structure". This repo was missing most of it — the material existed, but in the
    private working repo, where no judge will ever see it.
    Missing source code, now here:
    - firmware/farm_os/ STM32U585 sketch. This is HALF the system (motors, seeder,
    soil, battery, diagnostics over RouterBridge) and none of it
    was in the submitted repo.
    - firmware/esp32_cam/ ESP32-CAM MJPEG + WiFi tending + /status dia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
    [partitions.csv]
2026-08-16 docs: lead with why the robot exists; real run artifacts; current status
    README and demo-plan now open with the problem rather than the parts list. Sowing on a
    smallholding turns on when (local panchangam / biodynamic calendar — groundnut on Keel
    Nokku Naal) and where each seed lands, and both are done by hand:
    - seed: hand-broadcasting over-sows to compensate for uneven placement
    - water: on drip land the water arrives AT THE EMITTERS, so a seed placed anywhere else
    is watered indirectly or not at all — which is why the robot finds emitters by sight
    and seeds to them instead of assuming a spacing
    - soil: punching one hole per seed disturbs far less than preparing a tilled seedbed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
    [battery-log.csv]
2026-08-16 docs: explain what the UNO Q's dual-brain split actually buys; drop arc steering
    Added "How the UNO Q is used" to the README. The docs described four acts but never
    said why this board, and the answer is load-bearing rather than decorative:
    The seeder's punch must hold for exactly 500ms while a neural network runs on the
    same board. plantSeed is a single RPC the STM32 executes atomically — drum release,
    settle, coil on, 500ms, coil off — so a busy Linux side, a GC pause, or a dropped
    bridge cannot stretch the time a pulse-rated solenoid is energised. The Qualcomm
    side is free to be slow because it is not holding a stopwatch.
    Also recorded: both AI workloads (Gemma via Ollama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
2026-08-16 fix(ml): bind the model in app.yaml; enable the ML path; new board paths
    The trained FOMO model now actually drives the detector. Three things were wrong, and
    every one of them failed SILENTLY.
    1. THE MODEL IS BOUND IN app.yaml, NOT BY THE APP LAB UI. Brick entries are mappings:
    - arduino:object_detection:
    model: ei-model-1088852-1
    App Lab resolves that id to its own store and writes the path into the generated
    compose. Before this, every `arduino-app-cli app start` silently reverted to the
    stock yolo-x: the app ran, the runner reported healthy, and it served 80 COCO
    classes. Nothing anywhere said the wrong model was loaded. Verified now with
    /api/info -> labe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
2026-08-17 fix(vision): find the tube by projection profile, not Canny+Hough
    detect_tube was not tracking the tube at all. On a real run the reported column
    jumped 233 -> 290 -> 158 -> 61 -> 256 within about two seconds: it took the median
    of scattered soil edges, so steering was driven by noise and every run behaved
    differently. Measured on 20 saved frames, Hough found 0-8 "near-vertical" segments
    spread up to 179px across a 320px image, and missed tubes that are plainly visible.
    Both detectors now share one primitive (_profile_line), built on two facts:
    * GEOMETRY IS KNOWN. The followed row runs top-to-bottom, a crossing runs
    left-to-right. Collapsing the frame onto the axis the tube is NOT along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
    [test_crossing.py, tune_crossing.py]
2026-08-17 feat(firmware): gyro on Wire2 — turns closed on measured rotation, not time
    The pivot was timed: run the motors for tstartup + deg/tdps and hope. That premise
    is false. CAL["tdps"] = 45.2 was measured on soil; the gyro measures 68-70 deg/s for
    the same command on a hard floor, and 45-61 on soil as the ground compacts. There is
    no single correct value, so the row change kept landing crooked — which is what put
    the robot beside the drip lateral instead of on it.
    pivotDeg(deg, pwm, right) now drives until the CHASSIS has rotated far enough. Skid
    no longer costs angle; it only makes the turn take longer, because the gyro watches
    the body rather than the wheels. Measured over four consecutiv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
    [farm_os.ino]
2026-08-17 feat(console): multi-lateral drip seeding, and stop driving blind
    Everything here came out of dry runs going wrong in a specific, logged way.
    DROVE ON WITH NOTHING IN VIEW. The drip branch ended in `elif not detected or not
    armed:`, so a frame with an emitter detected AND armed but inside the re-plant floor
    matched no branch at all — no drive call, no stop call — and the last setMotors stayed
    latched. The robot kept going until the operator hit Stop. Stopping when the tube is
    lost is now the FIRST decision in the chain rather than the last.
    STOPPED AT THE WRONG PLACE. The plant trigger used confidence alone, so it fired the
    instant an emitter entered view — metres away, at a differen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
    [main.py]
2026-08-17 test(scripts)+docs: gyro/turn bench modes, and the A4/A5 I2C findings
    field_test gains four modes, each answering one question:
    gyro is it alive, and how much RESIDUAL rate is left after removing bias — that
    times the turn length is the error integration will accumulate. Note the
    window matters: over 200ms it reads 0.02 dps, over 12s the bias wanders to
    ~1 dps, which is ~2 deg on a real turn.
    gspin SCALE, isolated. Motors off; you turn the robot by hand through a known
    angle. A full 360 is far easier to call accurately than 90 (same reasoning as
    tsolve), and it removes skid, coast and PWM from the measurement. This is what
    valid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
    [field_test.py]
2026-08-18 feat(camera): USB webcam replaces the ESP32-CAM — 1.4 fps to 30 fps
    Three days of "course correction is broken" was the camera. Measured with the robot
    app stopped and curl straight from a laptop, so no project code in the path:
    ESP32-CAM MJPEG: 11 frames in 8s = 1.4 fps, variable 0.7-6.7
    single /capture: 2.75 s
    ping: 125 ms avg, 300 ms peak
    At 0.17 m/s that is 12-24 cm of ground per control measurement, against a lookahead
    only 22 cm deep. No gain, weight or detector threshold can fix a loop that sees the
    world once per quarter-metre — and every one of ours had been tuned against it.
    MEASURE THE FRAME RATE BEFORE TUNING ANYTHING DOWNSTREAM OF IT.
    A Logite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
    [esp32_cam.ino, test_frame_bus.py]
2026-08-18 fix(console): unbreak the camera loop, and stop guessing where the tube is
    THE CRASH FIRST. _cam_loop read `holding` at line 892 but only assigned it at 911,
    so the first fresh frame of every run raised UnboundLocalError and the loop thread
    died. Shipped with the grace-period change; nothing has worked since.
    The second-order damage was worse than the typo. bus.stop() was the last STATEMENT
    of the loop rather than a guaranteed one, so when the thread died the FrameBus reader
    survived and kept streaming the V4L2 device. A V4L2 camera streams to one consumer,
    so every subsequent Connect opened the same device, got no frames, and leaked another
    orphan reader — the camera stayed dead until th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
    [main.py, test_emitter_creep.py]
2026-08-18 fix(console): derive the camera gates from the measured frame rate
    The bug was never a wrong number, it was a wrong UNIT. Every gate in the camera loop
    was a count of seconds or pixels chosen against a camera that delivered a frame every
    ~710ms. The USB webcam delivers one every ~33ms, so on the day the camera changed each
    of them silently changed meaning by 21x and nothing failed loudly:
    _TRACK_MAX_JUMP_PX = 70 sized for 12-24cm of travel between frames. At 0.57cm it
    rejected nothing — the backstop against the tube column
    teleporting (233 -> 290 -> 158 -> 61) had gone inert.
    _TRAVERSE_MIN_SIGHTS = 4 over 2.5s. At 1.4fps that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
    [main.py, test_gates.py]
2026-08-18 test(ml): measure the emitter model instead of eyeballing it
    The model was known to be unreliable but never MEASURED, so every discussion about it was
    about where to put _EMIT_CONF. Scoring the whole of captures/usb (77 frames) against the
    deployed model settles that argument: it fires on 56 of 77 with a MEDIAN confidence of
    0.916, and cap_20260818_040718_843.jpg scores 0.997 on a frame that holds nothing but
    plain drip tube — verified by looking at the pixels, not inferred.
    A high fire-rate with a high median and no gap in the distribution is the signature of a
    model answering "tube" rather than "emitter", and it means NO threshold separates them.
    That is only visible if you score a fold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
2026-08-18 refactor(console): emitter inference on its own thread, off the control loop
    Inference costs 70-90ms and used to run inline, so the control loop ticked at ~10Hz. That
    was patched with a 0.30s cache: run the model periodically, reuse the last answer between
    runs. It raised the loop rate and introduced a quieter fault, because the cached box's ROW
    sets the creep distance — so a 0.3s-old box places the seed up to 5cm from the emitter,
    and seed placement is one of the few decisions here that no later frame can correct.
    The cache was the wrong SHAPE for the job, in three ways rather than one:
    * IT BLOCKED. At every expiry the steering loop stopped for 80ms to run a model that
    steering d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
    [main.py, test_emitter_worker.py, test_gates.py]
2026-08-18 fix(camera): the stale-frame floor was six centimetres of blind driving
    stale_after() decides how old a frame may be before the stream counts as DEAD and the
    motors stop. It was floor=0.35 / mult=3, and on the USB camera THE FLOOR WAS THE BINDING
    CONSTRAINT — 3 x 33.5ms is 0.10s, so `mult` never came into it and every decision was made
    by a number chosen for a different camera. 0.35s at 0.170 m/s is 6cm of driving with no
    eyes, per hiccup.
    The floor was there to protect the 1.4fps ESP32-CAM from a gate tighter than its own frame
    interval. But `mult` already does that far better than a fixed floor can — 6 x 710ms
    saturates the 3s cap — so the floor was only ever binding on a FAST camer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
    [test_gates.py]
2026-08-18 tools: one script to unstick the webcam's white screen
    The C310 goes blank white because its AUTOMATIC WHITE BALANCE latches — a known
    uvcvideo/C310 quirk that every Linux thread on it resolves the same way: turn the auto-WB
    control off and back on so the driver re-runs the algorithm. No replug, no container
    restart, and the app can keep streaming throughout. This is NOT the `Failed to resubmit
    video URB (-1)` message in dmesg, which is a separate and mostly benign USB-controller
    scheduling complaint on ARM boards.
    ssh unoq 'bash -s' < scripts/fix_camera.sh # no install needed
    ssh unoq 'bash -s' -- --show < scripts/fix_camera.sh
    ssh unoq 'bash -s' -- --pin < scripts/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
2026-08-18 fix(vision): the width gate was discarding two thirds of every run
    Recall on a real pass was 33%. It is now 86%, the longest stretch with no reading fell from
    6.57s to 1.10s, and halts from 37 to 11 — measured over 2086 CONSECUTIVE frames from one
    81-second pass at 26.3fps, which is the first dense data this detector has ever been
    measured against.
    THREE SEPARATE FAULTS, and the first one hid the other two.
    1. `_TUBE_MIN_W_PX = 30` GATED ON A NUMBER THAT IS NOT A WIDTH. `width` is
    |partner-peak|*2 when pair-centring succeeds and the FWHM when it does not, AND it comes
    from the WHOLE-FRAME profile, which smears as soon as the tube leans. So it collapsed
    exactly when the robot was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
    [main.py, test_gates.py, test_tube_detect.py]
2026-08-18 fix(console): relock was jumping the anchor onto noise; measure travel with the camera
    TWO ITEMS OFF THE FRAME-BUDGET AUDIT, both measured against the 2086-frame dense pass.
    1. RE-ACQUISITION. The jump gate fires on 7% of a real pass, so it needs an escape or a
    genuine move would be rejected for ever. The old escape counted six consecutive rejects
    and then believed WHICHEVER FRAME HAPPENED TO BE SIXTH. Measured: of 9 relock events, 6
    were onto a consistent position (spread 1-22px) and 3 were onto pure scatter — spreads of
    185px, 79px and 54px. One relock in three moved the anchor onto noise, and a bad anchor
    then poisons the gate for every frame after it.
    A relock now r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
    [main.py, test_gates.py, test_odometry.py]
2026-08-18 fix(ml): retract the "0.997 on plain tube" claim; _EMIT_CONF 0.90 -> 0.80
    CORRECTING f00dbe7, which recorded that cap_20260818_040718_843.jpg scored 0.997 on a frame
    holding "plain drip tube and no emitter" and made that the headline justification for
    retraining. THAT FRAME CONTAINS EMITTER HOLES. It was judged at full-frame zoom, where a 4-6px
    hole is simply not visible; cropping and upscaling later found them, and the old model's
    detection at (238,60) sits ~16px from one. The conclusion was never revisited after the zoom,
    so a wrong claim propagated into the commit message, the doc and the published audit.
    WHAT SURVIVES: a 73% fire rate with a 0.916 median and no gap in the distribution w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
    [main.py]
2026-08-18 fix(vision): search near where the tube WAS — and test against real frames
    TWO FIELD RUNS SETTLED WHAT NO OFFLINE MEASUREMENT COULD.
    _MIN_BANDS went 4 -> 3 -> 4 -> 3 in one day, and each move was justified by recall on frames
    where the tube was PRESENT. The field kept contradicting it:
    10:44 bands [135.5, 268.0, 278.5, 293.5] one on the tube, three on an overexposed edge.
    3 bands reported x=293 and the robot steered off the row on the FIRST FRAME of a run.
    12:16 bands [178.0, 173.5, 197.0, 159.0] ALL FOUR on the tube, 38px of scatter across a
    ~35px tube. No line fits four, so 4 bands rejected 100% of frames — travelled froze at
    0.23m and the robot sto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
    [test_golden_frames.py, test_tube_detect.py]
2026-08-18 fix(odometry): integrate SIGNED flow — rectified noise read 66% long
    MEASURED: 0.274 m reported over a tape-measured 0.165 m. Not drift, not scale — a sign bug.
    The odometer summed abs(dy) every frame. Vibration and correlation noise make dy jitter around
    zero even when the robot is still, and taking the absolute value turns that jitter into forward
    motion: every wobble in either direction adds distance and nothing ever subtracts. Over a 1 s hop
    at 19 fps that is 19 chances to accumulate noise as progress. The error scales with roughness and
    frame rate, which is exactly the 66% seen — and the faster camera made it WORSE, since 30 fps
    rectifies more samples per metre than 1.4 fps ever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
    [test_odometry.py]
2026-08-18 feat(plot): measure heading every hop with the gyro, and log what it sees
    THE PROBLEM: plain-land runs veered, occasionally and unpredictably, and nothing measured it.
    Hops were timed-open-loop — command both wheels for N ms and hope — so a wheel slipping on one
    side became permanent heading error, and the next hop inherited it. Over a 13-hop row the errors
    compound and the row bends. The gyro was already fitted and already closing the row TURNS; the
    straight hops were the one motion still flying blind.
    THE DESIGN, which is the operator's: take the start heading as the reference, measure the
    rotation of each hop, accumulate the difference, and pivot it back out once the total crosses a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
    [farm_os.ino, main.py, test_console_imports.py]
2026-08-18 test(golden): commit the frames — the suite was skipping GREEN without them
    The golden-frame tests read their images from ../ai-labs/apps/farm-robot/captures/golden, which
    is gitignored as bulk capture data. So on this laptop they ran, and anywhere else every one of
    them hit pytest.skip and the suite reported GREEN while testing nothing at all. That is the same
    class of defect as the duplicate-frame odometer test: a test that cannot fail is a note, not a
    regression test — and I shipped it in that state one commit ago.
    Seven hand-labelled frames are 400KB. That is a FIXTURE, not a dataset, and it belongs in the
    repo beside the test that needs it. The thousands of raw captures stay next d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
    [test_golden_frames.py]
2026-08-18 test(negative): the false half — and it found a false positive that STEERS
    Every detector measurement made on 2026-08-18 used frames where the tube was present: the
    2086-frame dense pass, the 303-frame set, the golden seven. All positives. So the false-positive
    rate was completely unmeasured, and that is not a small gap — it is why _MIN_BANDS moved
    4 -> 3 -> 4 -> 3 in a single day. Each move was justified by recall on positives, and each was
    then contradicted by a field frame where the detector confidently found a tube that was not there.
    The nine frames in crossing-frames/ turn out to be usable negatives: bare soil with a lateral
    running ACROSS the direction of travel. That makes them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
2026-08-18 feat(log): make a false positive VISIBLE, and stop frame saves overwriting
    Two instrumentation gaps that would have made tomorrow's crossing-lateral false positive as
    invisible as today's was.
    1. AN ACCEPTED BAD FRAME IS LOGGED NOWHERE. Every diagnostic in the camera loop records frames
    we REJECTED — the reject tally, the lost-frame dump, the LOST/REGAINED edges. A false positive
    is accepted, and produces no found->not-found edge either, so it appears in none of them. That
    is why it could only be found offline against saved frames.
    Added a screen on the frame-to-frame JUMP, plus a frame save. It is a SCREEN, NOT AN ALARM,
    and the threshold is measured rather than reasoned: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
2026-08-18 feat(camera): tooling to lock focus on the new QHM-999RL webcam
    NEW CAMERA, measured on the board 2026-08-18. QHM-999RL (SunplusIT 0806:0806), replacing the
    dead C310. It works, and it is better hardware:
    auto-detected as /dev/video2 (find_uvc_camera() got it right with no change — video0/1 are
    now the Qualcomm Venus codec nodes, exactly the index shuffle
    camera.py already documents)
    formats MJPG + YUYV, 320x240 through 2048x1536
    driver-level fps 24.4 at EVERY format and resolution tested, 320x240 MJPG
    through 1280x720 MJPG and 640x480 YUYV
    en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
2026-08-19 feat(camera): lock the new webcam's focus, and make it survive a replug
    The QHM-999RL powers up with continuous autofocus ON (focus_automatic_continuous=1; the UVC
    default is 0, so this is the camera's own firmware). On a camera at fixed height above the ground
    that is pure liability, and the numbers are not marginal — measured ON THE ROBOT at its real
    mounting height, sweeping focus_absolute 0..1023 at 320x240:
    sharpness (Laplacian variance) 28 .. 324 11.6x spread, clean unimodal peak at 272
    Defocus attacks precisely what the tube detector gates on: _TUBE_MIN_FWHM_PX = 5 and
    _TUBE_MIN_SIGMA = 2.5 measure profile width and contrast, so a hunting lens yields intermittent
    fwhm/si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
    [lock_focus.py]
2026-08-19 feat(camera): tool to calibrate PX_PER_M_DEPTH for the new lens, by hand-push
    PX_PER_M_DEPTH = 1090.0 was measured with the Logitech C310. The robot now has a QHM-999RL — a
    different lens, different field of view — so that constant is a C310 number being applied to a
    camera nobody has measured. It is not cosmetic: the odometer's entire output is
    distance_m = |net_dy| / px_per_m
    so an error there is a straight multiplicative error on every distance the camera reports, and
    the odometer is what gates end-of-row in tube following.
    WHY THE 43cm FRAME MEASUREMENT DOES NOT SETTLE IT, though it is the right input. The frame covers
    43cm of ground top to bottom, which naively gives 240px /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
    [calib_odometer.py]
2026-08-19 fix(odometry): PX_PER_M_DEPTH 1090 -> 729.2, MEASURED on the new camera
    1090.0 was a Logitech C310 number. That camera is dead and the robot now has a QHM-999RL with a
    wider lens, so the constant was simply the wrong camera's answer — and it is a straight multiplier
    on the odometer's entire output:
    At 1090 against a true 729 the camera under-reported every distance by a third. In tube following
    that is what gates end-of-row, so a 5m lateral would have been declared finished after ~3.3m.
    DERIVING IT FROM THE FRAME GEOMETRY DOES NOT WORK, which is why this took a measurement. The frame
    covers 43cm of ground top to bottom, naively 240/0.43 = 558 px/m. B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
    [calib_odometer.py, main.py]
2026-08-19 fix(plot): heading correction back to MEASURE-ONLY — the gyro has a systematic bias
    The sign is confirmed and the plumbing works, but the corrector would be integrating fiction.
    MEASURED with five STATIONARY yawHop calls at the real plot hop length (2121 ms = startup -0.303s
    + 0.40m / 0.165 m/s) at ZERO PWM, so every degree is phantom:
    +0.04, +0.41, +0.29, +0.44, +0.43 -> +1.61 deg over 5 hops = +0.32 deg/hop
    ALL THE SAME SIGN, so it accumulates rather than cancelling. The firmware reported bias -0.21 dps
    on every call and still left ~+0.15 dps behind — the per-hop bias window is too short to catch it.
    A 13-hop row is +4.2 deg, safely under the 10 deg threshold, which is why t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
    [main.py]
2026-08-19 fix(drip): the field session — traverse crash, emitter re-arm, distance, gyro tare
    One commit because every change is in main.py and they were found and validated together across
    five drip dry runs on 2026-08-19. In rough order of how much they were costing:
    1. TRAVERSE CRASHED ON ITS FIRST LOG LINE, every time.
    TypeError: object of type 'int' has no len()
    main.py:1609 len(sights), len(cross_hist), ...
    _traverse_track returns sights and frames as COUNTS; the log line wrapped both in len() again.
    It killed the camera loop the instant traverse began, and the finally correctly cut the motors —
    which is the "robot stopped dead after the turn" symptom. It also answ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
    [main.py, test_heading_tare.py]
2026-08-19 test(emit): count emitters over the real frame geometry, in GROUND units
    Reproduces the one-emitter-per-lateral failure and pins its cause, so the re-arm condition cannot
    drift back. The reproduction is the point: with the old frame-exit condition and the QHM's 0.43m
    view it plants exactly 1 over 5m, matching the field; with the C310's 0.22m view the same condition
    plants 12. That asymmetry IS the bug, and expressing the test in metres of ground rather than pixels
    or frames is what makes it visible — a constant written in frames silently changed meaning when the
    lens changed.
    WHAT THIS FILE TAUGHT ME ABOUT MY OWN TESTS. The first version omitted `armed = False` after a
    plant, which the ca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
2026-08-19 fix(traverse): identify the lateral by POSITION, and stop rotating to centre it
    THE FAILURE. The robot completed a traverse, found the next lateral, pivoted onto it — and drove
    back down the row it had just finished. Three separate faults, and the operator spotted the one
    that mattered: during the turn it acquired the PREVIOUS lateral.
    That is not a false positive. The old lateral is a real tube, correctly shaped, at full confidence.
    The only thing wrong with it is WHERE it is — so no gate on shape, strength or agreement can tell
    the two apart. Position is the only discriminator, and the geometry makes it a clean one:
    frame covers ~0.57 m across (320 px at 1.79 mm/px)
    row gap 0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
    [main.py, test_align_onto_tube.py]
2026-08-19 test: barebones e2e suites for tube, emitter and traverse — with the frames committed
    Three suites, organised by the CONDITION each covers, because the failures are condition-specific
    and a single lumped "does the vision work" test hides which one is broken. Frames are committed with
    them: a fixture that lives outside the repo is a test that silently skips, which this project has
    already been bitten by once.
    SUITE 1, tests/test_tube_e2e.py — tube finding: centred / offset / shadowed.
    Six shadow frames supplied by the operator are committed under tests/frames/shadow/. Their labels
    are deliberately EMPTY and those cases skip, because I could not establish ground truth honestly:
    * "dark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
    [test_emitter_e2e.py, test_traverse_e2e.py, test_tube_e2e.py]
2026-08-19 research(vision): shadow rejection — brightness cannot separate a dark tube from a dark shadow
    The tube detector profiles a GRAYSCALE image, and that is the root of the shadow problem. Measured on
    tests/frames/shadow/cap_20260818_083851_243.jpg, a hard horizontal shadow edge crossing a strong
    vertical tube:
    region V S R-B
    tube, lit 80.9 73.9 -23.4
    tube, shadow 36.6 145.4 -20.8
    soil, lit 172.1 10.0 +5.7
    soil, shadow 42.0 45.8 -6.1
    BRIGHTNESS DOES NOT SEPARATE THEM: tube-in-shadow V=36.6 against shadowed soil V=42.0. Five units
    apart. No threshold, no profile, no band-fit on that channel can tell them apar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
    [shadow_channel_probe.py]
2026-08-19 test(emitter): the retrain worked — pin v8, and fix the suite so it can run on the board
    MEASURED against ei-deployment-version 8 on the board, same frames as v6, so this is a direct
    before/after on identical inputs:
    frame v6 v8 delta
    emit2_lat1_025342_761.jpg none 0.79 @y186 GAINED, and MID-frame
    emit2_lat1_025653_793.jpg none 0.66 @y210 GAINED
    emit2_lat2_023344_413.jpg none 0.96 @y180 GAINED, and MID-frame
    emit3_lat1_025834_914.jpg 0.65 @y222 1.00 @y204 +0.35
    emit3_lat1_024725_616.jpg 0.73 @y198 0.97 @y210 +0.24
    emit2_lat1_025825_168.jpg 0.75 @y222 0.97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
    [test_emitter_e2e.py]
2026-08-19 feat(traverse): save the frame behind every traverse tick — the failure is undiagnosable without it
    A traverse failed on 2026-08-19 and could not be investigated, because drip mode does not enable
    dataset capture: a 1.6m traverse left exactly ONE frame on disk, the decision frame, and the entire
    sequence that led to it was gone.
    WHAT THE NUMBERS DID SAY, which is enough to identify the fault but not to test a fix:
    traverse 0.00m found=True y=223.5 near=0.93 | grew +0px (need 6px)
    traverse 0.34m found=True y=221.0 near=0.92 | grew -2px (need 62px)
    traverse 0.85m found=True y=218.0 near=0.91 | grew -2px (need 63px)
    traverse 1.18m found=True y=214.5 near=0.89 | grew -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
    [main.py]
2026-08-19 feat(emitter): a conveyor instead of a blind creep — one stop per emitter, within 5 cm
    THE FAULT. On the 07:18 run of 2026-08-19 the retrained model detected an emitter on 96 of 96 frames
    in one window — recall was no longer the problem — and the robot still stopped only 7 times over a row
    holding about 13 emitter positions. Every other one. The cause is geometric, not a detection failure:
    punch tip sits 0.39 m behind the NEAREST visible ground
    emitters are 0.40 m apart
    "See an emitter, then creep it under the punch" therefore consumes at least one whole spacing with the
    camera unconsulted. The logged creeps were 0.45, 0.46, 0.51, 0.46, 0.47, 0.47, 0.43 m — every on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
    [main.py, test_emitter_creep.py]
2026-08-19 fix(emitter): the model fires on PLAIN TUBE at 0.97 — stop patching the counting logic
    THE FRAME THAT ENDED TEN ITERATIONS is committed at tests/frames/plaintube/. The robot was parked at
    the 1.10 m mark of a dry run — one of two stops that matched no real emitter — and the frame contains
    NO EMITTER AT ALL. It is plain tube. The model returns THREE boxes on it, at confidence 0.77, 0.97 and
    0.94, stacked along the pipe at 79, 72 and 64 cm ahead of the punch.
    So every counting scheme written today was counting the tube itself. That is why the commit band was
    occupied on 70-96% of frames and why the stop count came out paced by whatever lockout was set rather
    than by emitters:
    locko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
    [main.py]
2026-08-19 fix(vision): pair-centring must not leave the seed window — negative FPs 4/9 -> 1/9
    `_profile_line` finds a peak inside the seed window, then looks for an opposite-signed partner and
    reports the MIDPOINT of the pair — because the tube is a lit cylinder and centring on the highlight
    alone biases the estimate by ~25 px. Nothing re-checked that midpoint against the window.
    Found while diagnosing an operator frame where the robot stopped with the tube plainly visible: the
    caller asked for x=185 +/- 20, so 165..205, and a band returned 147.5 — 38 px OUTSIDE the window,
    sitting on a dark soil region. The peak had been on the tube; only the pairing moved it.
    pair_win=45 -> pos=147.5 3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
    [test_golden_frames.py]
2026-08-19 docs(demo-plan): refresh three-day-stale status before submission
    The plan contradicted the robot in ways a judge reading it would catch:
    - Act 3a listed as not started. It runs end-to-end on the real drip line.
    - FOMO deploy listed as "needs the USB cable". It is bound in app.yaml and
    never needed the cable.
    - Chat UI listed as a standalone prototype. It is a console tab.
    - MPU-6050 filed under "next revision". It is fitted, on A4/A5 via Wire2,
    and every turn is closed-loop on it (0.3 deg worst over four 90s). Cost
    A4, so BATT_PRESENT 0 and runs need nobatt.
    - ESP32-CAM listed as the vision sensor. A USB webcam replaced it.
    - Tube detection described as Canny/Hough. It is a projectio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
2026-08-19 docs: colour-coded circuit schematics, generated from code, + as-built BOM
    The rubric names "circuit schematics" explicitly and we had none -- 474 lines
    of ASCII in uno-q-wiring.md and no diagram. Four sheets now: power, drive,
    seeder, gyro, colour-coded by net class (12V red, 5V amber, logic/I2C blue,
    ground grey) with a legend, so a wire's job is readable without tracing it.
    Generated by scripts/gen_schematic.py (schemdraw) rather than drawn in a GUI,
    because the schematic has to stay true to firmware that moves: A4 was the
    battery divider until the gyro took it, EC drive moved off D10 when the seeder
    spool claimed it, and A5 has been three different things. This diffs like code
    and every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
2026-08-19 docs(schematic): a self-contained twin for publishing
    index.html references the sheets as <img src="power.svg">, which is right for
    the repo -- the SVGs stay separately usable in a slide or the README. But a
    published artifact is one file behind a strict CSP, so those relative sources
    silently render as broken images. I published it that way first and it was
    exactly that.
    gen_schematic.py now also emits index.standalone.html with the four SVGs
    inlined: the pt width/height are stripped so they scale, the viewBox is kept,
    and each sheet scrolls inside its own container so the page body never scrolls
    sideways. Verified at 720px and 1200px -- no page-level horizontal scroll, and
    the wide sheets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
    [gen_schematic.py]
2026-08-19 docs: drop uno-q-wiring.md; the schematics are the circuit reference now
    The file was byte-identical to the ai-labs copy (md5 b1109a78...), which stays
    put, so nothing is lost -- including the solenoid low-side circuit at its line
    252 that sheet 3 was drawn from. Removed here because a 474-line ASCII pinout
    maintained in two repos is a second source of truth that will drift.
    References repointed at docs/schematic/: README (the I/O section and the doc
    table), bom.md, troubleshooting.md x3, the schematic page footer, and the
    seeder pin comment in farm_os.ino. drive-precision.md already cited the
    ai-labs path, so that one is now named as a cross-repo reference. Checked: no
    dead relative links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
    [farm_os.ino]
2026-08-20 docs(bom): tables first, prose collapsed — and fix the seeder parts list
    Every section now leads with its table, with the reasoning behind it folded
    into a <details> block. A BOM is a list first; a judge scanning for parts and
    prices should not have to read past a fire report to reach the next table. The
    reasoning stays one click away rather than being cut, because that is what the
    documentation criterion actually rewards.
    Five parts claims were wrong, all operator-corrected:
    - The arm rides on a LAZY-SUSAN BEARING, which was missing from the list
    entirely — and it is what takes the punch load off the servo.
    - No compression springs. They were listed; they are not fitted.
    - The 3D-pri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
2026-08-20 docs(bom): cut the filler, and the next-revision wishlist
    Three removals, all of them things the reader did not ask for:
    - "Pin assignments below are taken from farm_os.ino, not from memory" —
    reassurance about my own process, which is not information about the robot.
    - "A dash means the item was already owned or came as part of a kit, so no
    separate price is meaningful" — a dash in a price column already reads as
    no price.
    - The whole "Identified for the next revision" table. A bill of materials is
    what is fitted; a wishlist of parts that are not on the robot belongs
    nowhere near it.
    Repointed drive-precision.md, which linked into that deleted section, at what
    bom.md actuall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
2026-08-20 docs: move demo-plan.md to the ai-labs repo
    The demo plan is build-process material -- storyboard, tracked checklists,
    what is done and what is not. It belongs with the working notes in
    ai-labs/apps/farm-robot, not in the repo a judge reads.
    An ancestor of it was ALREADY in ai-labs, dated 2026-08-09 and 64 lines
    shorter, with items still marked not-started that have since shipped. So this
    was a divergence, not a move: the yaerbot copy is the maintained descendant
    and now overwrites the stale one.
    Before overwriting I checked what only the old copy had, and rescued the part
    worth keeping -- the two rules that drive the demo, which the newer copy had
    flattened into one vague sentence about b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
2026-08-20 docs(seeder): mark what was designed but never built
    This is a pre-build design document and about half of it describes a robot that
    does not exist. A reader could not tell which half. Now every section carries
    a tag -- built, different, or not built -- and there is a table up front.
    Not built at all: soil-moisture peak detection, emitter-bump confirmation, the
    sensor-fusion state machine, clogged-emitter detection, soil-driven pattern
    adaptation, GPS logging, the RPi5 server, the mobile/WhatsApp app, the
    vibration motor. Most of that chain depended on soil sensors, and none are
    fitted.
    Corrected in the body rather than only noted:
    - The stepper is gone. There is no 28BYJ-48 and no ULN2003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
2026-08-20 docs(seeder): the hopper and drums are built; the ring patterns are not
    seeder.md is a pre-build design document and about half of it describes a
    robot that does not exist. A reader could not tell which half. Every section
    now carries a tag -- built, different, or not built -- with a table up front.
    Not built: soil-moisture peak detection, emitter-bump confirmation, the
    vibration motor. Most of that chain hung off soil sensors, and none are fitted.
    Corrected in the body, not just noted:
    - The stepper is gone. There is no 28BYJ-48 and no ULN2003;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
2026-08-20 docs(drive-precision): the turn problem it opens with is solved
    Audited against CAL in main.py and the firmware. The document was written
    during the open-loop era and still read as current.
    The headline is obsolete. It said accurate turns were "not achievable
    open-loop beyond ~±5°, an IMU is the real fix". The IMU is fitted and turns
    close the loop on measured angle: 0.3° worst across four consecutive 90s.
    Added a status note at the top so nobody reads the open-loop era as the
    present, and marked the IMU section done.
    The reference numbers were two calibrations stale AND from a duty the robot no
    longer uses. Plot mode now drives at creep (PWM 55) so one calibration covers
    plain-land and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
2026-08-20 docs(ml): it told the reader the opposite of the known root cause
    Audited against main.py, emitter_ml.py, app.yaml and the firmware.
    THE WORST ONE. A "CORRECTION" block withdrew the claim that the model fires on
    bare tube. That withdrawal was too broad: only the claim about ONE frame was
    wrong, judged at full-frame zoom where a 4-6px hole is invisible. Firing on
    plain tube is real and is the accepted root cause of the emitter count -- three
    boxes up to 0.97 on a frame with no emitter, and 145 boxes across 60 leaf-litter
    frames. Anyone following the doc would have concluded the opposite and gone
    looking for a threshold. Recorded, including that the retraction cost about ten
    iterations of cou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
2026-08-20 docs: CLAUDE.md -> AGENTS.md, and a table of contents
    Renamed with `git mv` so the history follows the file. Retitled "notes for
    Claude" to "operating notes", which is what it actually is: the three runtime
    services in start order, and how to deploy a change to the board. That title
    was the only Claude reference in it.
    Repointed the two docs that cited the old filename by name --
    troubleshooting.md for the MCU-flash recipe and usb-camera.md for the
    ground-loop warning.
    Updated while there, since both were stale:
    - `scripts/` was listed as two files. There are thirteen; named the ones worth
    knowing about. `docs/` had no entry at all for the schematics or the
    architecture diagram.
    - `PLA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
2026-08-20 docs(readme): lead with what the robot actually does
    The opening said "end-to-end agronomic agent: plans, acts, reports" and left
    the AI to a section 100 lines down. Anyone skimming learned nothing about why
    this is a Physical AI entry rather than a timed seed dropper.
    Now two short bullet lists: the two models that run on the board with no
    network, then what closes the loop while it drives. Bullets rather than prose
    because this is the part people scan.
    Every claim is one the robot has produced and that is checkable in this repo:
    - 0.3° over four consecutive 90° turns — the figure in main.py, cited in three
    places there.
    - "trained on photographs this robot took itself" — the capt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
2026-08-20 docs(readme): hero photo of the robot on the drip line
    Three things had to be sorted before the image could render:
    - assets/ was not tracked, so nothing would have shown on GitHub at all.
    - The file was named Yearbot.jpg -- capital Y, and "Year" for "Yaer". GitHub's
    filesystem is case-sensitive, so the lowercase path would 404 while working
    fine on macOS, and the spelling fights the ear etymology two lines below it.
    Renamed to match Yaerbot.mp4.
    - 2200x1586 at 6.6 MB is heavier than a README wants. Downscaled to 1600px
    wide: 377 KB, no visible loss at display size.
    Also gitignored assets/*.mp4 and *.mov. The demo video is 561 MB and GitHub
    hard-blocks any file over 100 MB on push,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
2026-08-20 docs(readme): link the demo video from the hero and as a text link
    Hero image now links to https://www.youtube.com/watch?v=LSY9eQG0oHc, with a
    separate captioned link under it so the video is reachable whether or not
    someone reads an image as clickable.
    The caption describes what the video ACTUALLY contains, checked frame by frame
    at fifteen timestamps rather than assumed: the problem shot, the architecture
    diagram, the planner, the seeder being built by hand, plain-land plot planning
    and run, and drip following with the live CV overlay beside the field footage.
    My first draft claimed "the run report" -- I could not find it in any sampled
    frame, so it is not claimed.
    Verified the link reso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
2026-08-20 docs(schematic): markdown, so GitHub actually renders it
    GitHub serves .html as source, so docs/schematic/index.html showed a wall of
    markup to anyone who clicked it -- the schematics were effectively invisible in
    the one place a judge looks.
    Replaced with docs/schematic/README.md. Naming it README.md means GitHub
    renders it automatically when anyone opens the folder, so the four sheets and
    their notes appear without anyone having to find a file. Uses GitHub's own
    alert blocks (CAUTION for the fire, WARNING for the diode, IMPORTANT for the
    dead SDA/SCL pins) rather than plain quotes, so the things that bite are the
    things that stand out.
    Checked the SVGs survive GitHub's sanitiser before r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
    [gen_schematic.py]
